patryk-homelab/ClaudeRepo/credits-3d/_wycofane_magnesy_2026-11-04/README.txt

Części na magnesy wycofane 04.11.2026 (decyzja Patryka: bez wklejania magnesów).
Pliki przeniesione tutaj z tymi samymi ścieżkami, jakie miały w credits-3d. Nic nie zostało skasowane; ostateczne usunięcie zostaje Patrykowi.
Powód dla każdej części: gniazda albo ramki na magnesy, sprawdzone przekrojami (narzedzia/magnet_pockets.py, wyniki w narzedzia/wyniki/magnes_*.json).
Amana i DeWalt: po 2 gniazda Ø6,1-6,2 mm na magnesy okrągłe 6 x 3 mm.

Później tego samego wieczoru (decyzja Patryka: wycofać wszystkie systemy z magnesami) przeniesiony tu cały folder 03_1051202 (także 3x7, 8x4, przegródki, etykiety, raport, rendery).
