patryk-homelab/ClaudeRepo/credits-3d/CREDITS.md

# Uznanie autorstwa (credits) — uchwyty na bity

Licencje sprawdzone 2026-11-04 w API Printables (pole `license`, `remixParents`). Żaden z 4 modeli nie jest remiksem (`remixParents: []`), więc nie ma licencji „wyżej w łańcuchu”.

| # | Projekt | Autor (Printables) | Link | Licencja | Sprzedaż wydruków | Obowiązek przy sprzedaży |
|---|---|---|---|---|---|---|
| 01 | Bit holder, organizer / Držák bitů | Jirka (`Jirka_4226633`) | https://www.printables.com/model/1770956 | CC0 (Public Domain) | tak | brak (podanie autora mile widziane) |
| 02 | Large bit holder (wall mounted) | Jirka (`Jirka_4226633`) | https://www.printables.com/model/1825701 | CC0 (Public Domain) | tak | brak (podanie autora mile widziane) |
| 03 | Ultimate Bit Holder | Carlos Gonzalez (`CarlosGonzal_2239591`) | https://www.printables.com/model/1051202 | CC BY (Creative Commons — Attribution) | tak | podać autora, tytuł, link i licencję; zaznaczyć zmiany — **wycofany 04.11.2026, nie sprzedawać** |
| 04 | Hex Bit Holder | GUZ_prints (`GUZ_prints_227736`) | https://www.printables.com/model/146076 | CC0 (Public Domain) | tak | brak (podanie autora mile widziane) |

## Teksty do wklejenia w ogłoszenie

**01 (CC0)**
> Projekt: „Bit holder, organizer” — Jirka, Printables (printables.com/model/1770956), licencja CC0.

**02 (CC0, wersja poprawiona)**
> Na bazie projektu „Large bit holder (wall mounted)” — Jirka, Printables (printables.com/model/1825701), licencja CC0. Zmiany: poszerzone gniazda w przednim rzędzie, otwory montażowe bez podpór.

**03 (CC BY — obowiązkowe)**
> (Wycofany 04.11.2026 – tekst zostaje tylko dla porządku.) Na bazie projektu „Ultimate Bit Holder” autorstwa Carlos Gonzalez, Printables (printables.com/model/1051202), licencja CC BY (Creative Commons — Uznanie autorstwa). Zmiany: naprawione siatki części 3x7 i 8x4 (bez zmiany kształtu).

Na OLX / Allegro Lokalnie, gdzie link może być niedozwolony: „Projekt: Ultimate Bit Holder, autor Carlos Gonzalez (Printables), licencja CC BY, zmodyfikowany”.

**04 (CC0, wersja poprawiona)**
> Na bazie projektu „Hex Bit Holder” — GUZ_prints, Printables (printables.com/model/146076), licencja CC0. Zmiany: dodane uszy montażowe z otworami na wkręty.

## Uwagi
- Nie pisać „projekt własny” przy żadnym z nich.
- Nazwy i logo marek z plików 03 (Amana, DeWalt) nie trafiają do tytułu ogłoszenia; to uchwyty pod konkretne narzędzia, nie produkty tych firm.
- Wersja licencji CC BY (3.0 / 4.0) nie jest podana w API Printables, tylko nazwa „Creative Commons — Attribution”.
