patryk-homelab/ClaudeRepo/credits-3d/wkretaki/CREDITS.md

# Uznanie autorstwa (credits) — uchwyty na wkrętaki

Licencje sprawdzone 2026-11-04 w API Printables (pola `license`, `remixParents`).

| # | Projekt | Autor (Printables) | Link | Licencja | Model nadrzędny | Obowiązek przy sprzedaży |
|---|---|---|---|---|---|---|
| 01 | Large screwdriver holder with honeycomb pattern | Jirka (`Jirka_4226633`) | https://www.printables.com/model/1808383 | CC0 | brak | brak (podanie autora mile widziane) |
| 02 | Large massive screwdriver holder / Masivní držák pro šroubováky | Jirka (`Jirka_4226633`) | https://www.printables.com/model/1782552 | CC0 | brak | brak |
| 03 | IKEA Skadis screwdriver holder / držák na šroubováky | Pavel (`Pavel_81109`) | https://www.printables.com/model/41393 | CC BY | brak | podać autora, tytuł, link, licencję; zaznaczyć zmiany |
| 04 | Wera Screwdriver Holder | ksuszka (`ksuszka_192195`), w skryptach: Krzysztof Suszka | https://www.printables.com/model/123412 | CC BY | Thingiverse thing:5213820 | podać autora, tytuł, link, licencję; zaznaczyć zmiany |

**04 — model nadrzędny.** Printables wskazuje Thingiverse thing:5213820. Według listingu-lustra (3dsearch.net, „Wera Screwdriver Holder by ksuszka”, widziany tylko w wynikach wyszukiwania) to upload tego samego autora. Strona Thingiverse zwraca z chmury błąd 403, więc licencji tamtej wersji nie odczytałem. Licencję CC BY na Printables nadał autor, więc jest ważna dla tej publikacji. Sprawdzenie strony Thingiverse w przeglądarce domowej zamknie tę kwestię.

## Teksty do ogłoszeń

**01 (CC0, poprawiony)**
> Na bazie projektu „Large screwdriver holder with honeycomb pattern” — Jirka, Printables (printables.com/model/1808383), licencja CC0. Zmiana: ujednolicony jeden otwór (bez podpór przy druku).

**02 (CC0, poprawiony)**
> Na bazie projektu „Large massive screwdriver holder” — Jirka, Printables (printables.com/model/1782552), licencja CC0. Zmiana: 21 niepełnych otworów przy krawędzi uzupełnionych do pełnego rozmiaru.

**03 (CC BY — obowiązkowe)**
> Projekt: „IKEA Skadis screwdriver holder” autorstwa Pavel, Printables (printables.com/model/41393), licencja CC BY (Creative Commons — Uznanie autorstwa). Pliki wyeksportowane z oryginalnego modelu FreeCAD autora, bez zmian kształtu.

**04 (CC BY — obowiązkowe)**
> Na bazie projektu „Wera Screwdriver Holder” autorstwa ksuszka (Krzysztof Suszka), Printables (printables.com/model/123412), licencja CC BY (Creative Commons — Uznanie autorstwa). Zmiana: szczelina odciążająca w zatrzasku (mniejsze ryzyko pęknięcia przy wpinaniu na szynę).

Na OLX / Allegro Lokalnie bez linku: „Projekt: <tytuł>, autor <autor> (Printables), licencja CC BY, zmodyfikowany”.

## Uwagi
- „IKEA”, „SKÅDIS” i „Wera” to nazwy cudzych marek. W ogłoszeniu tylko opisowo („pasuje do płyty IKEA SKÅDIS”, „do wkrętaków Wera”), bez logo i bez sugerowania, że to produkt tych firm.
- Wersja licencji CC BY (3.0 / 4.0) nie jest podana w API Printables, tylko nazwa „Creative Commons — Attribution”.
