patryk-homelab/ClaudeRepo/credits-3d/01_1770956_bit-holder-organizer_Jirka/render/oryginal.png

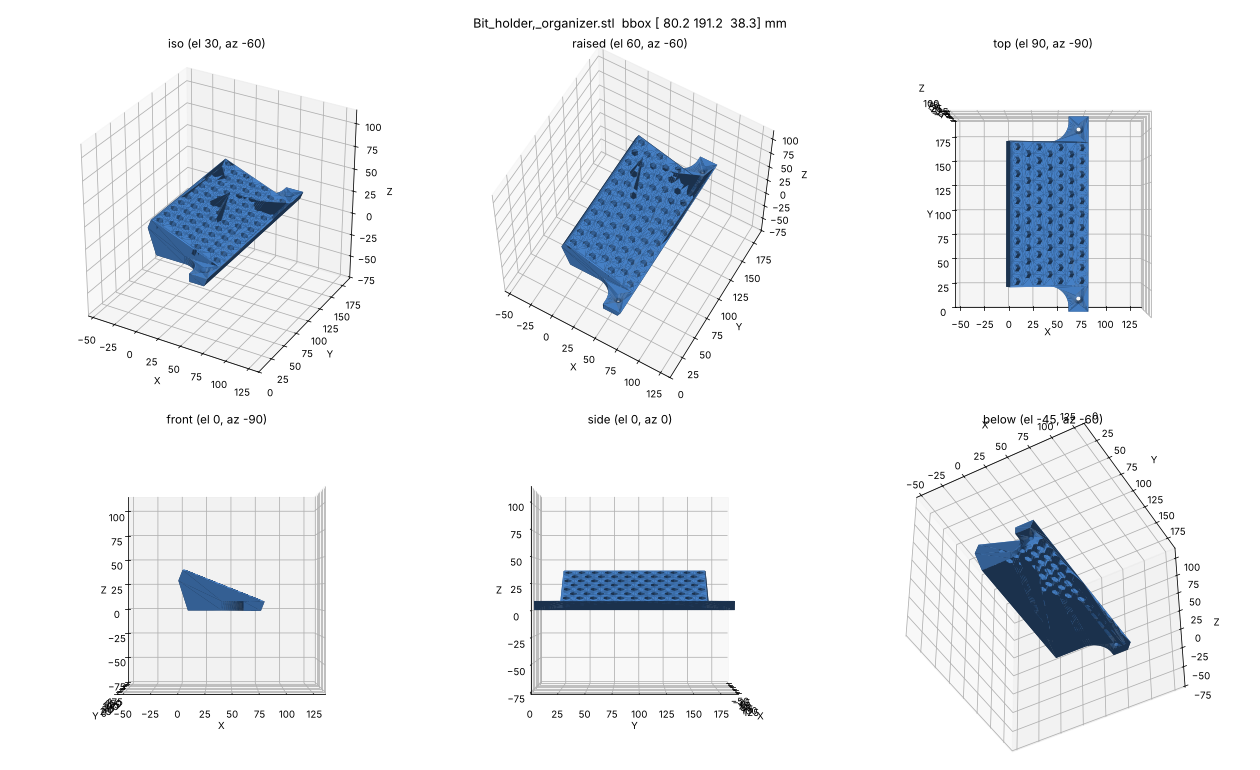
credits-3d/01_1770956_bit-holder-organizer_Jirka/render/oryginal.png
