patryk-homelab/ClaudeRepo/credits-3d/02_1825701_large-bit-holder_Jirka/render/oryginal_gniazda_z6.png

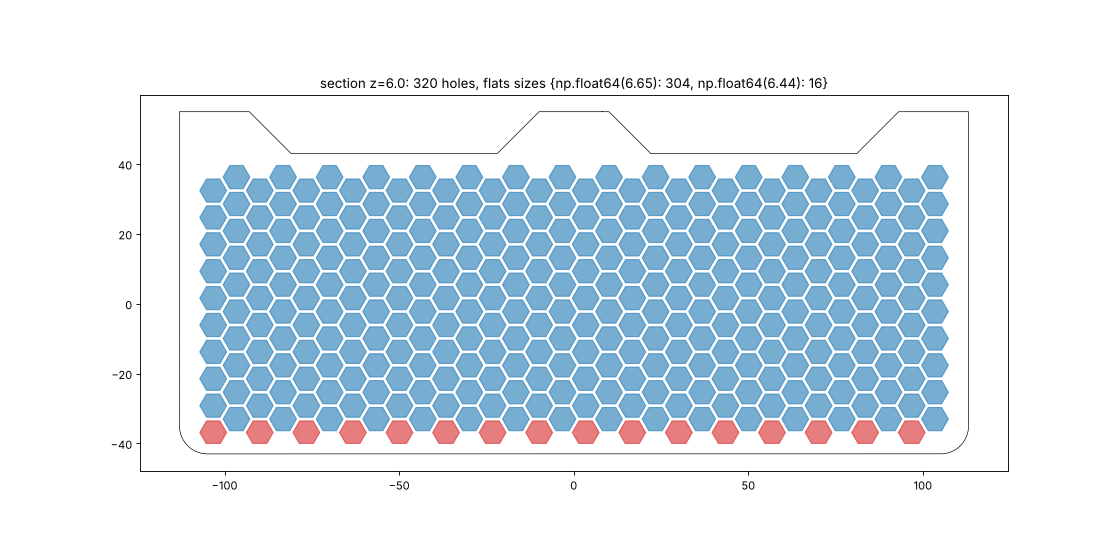
credits-3d/02_1825701_large-bit-holder_Jirka/render/oryginal_gniazda_z6.png
