patryk-homelab/ClaudeRepo/credits-3d/02_1825701_large-bit-holder_Jirka/render/poprawka_szczegoly.png

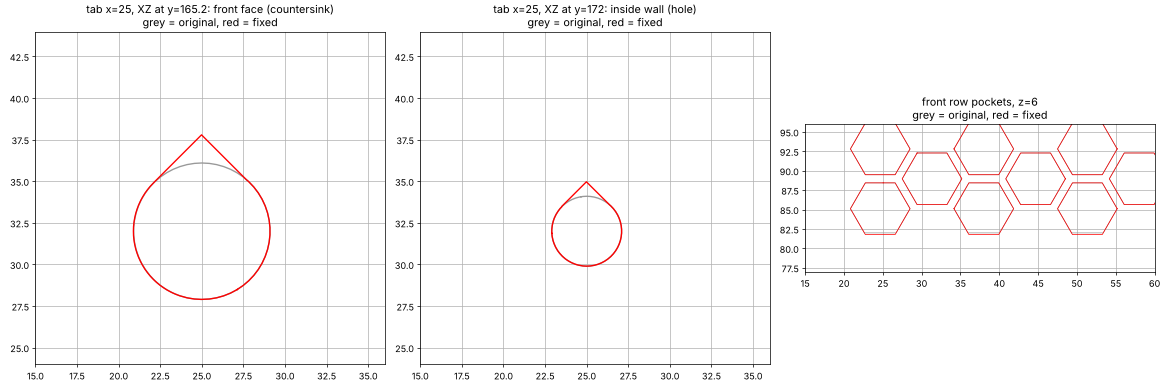
credits-3d/02_1825701_large-bit-holder_Jirka/render/poprawka_szczegoly.png
