patryk-homelab/ClaudeRepo/credits-3d/_wycofane_magnesy_2026-11-04/03_1051202_ultimate-bit-holder_CarlosGonzalez/render/8x4_naprawiony.png

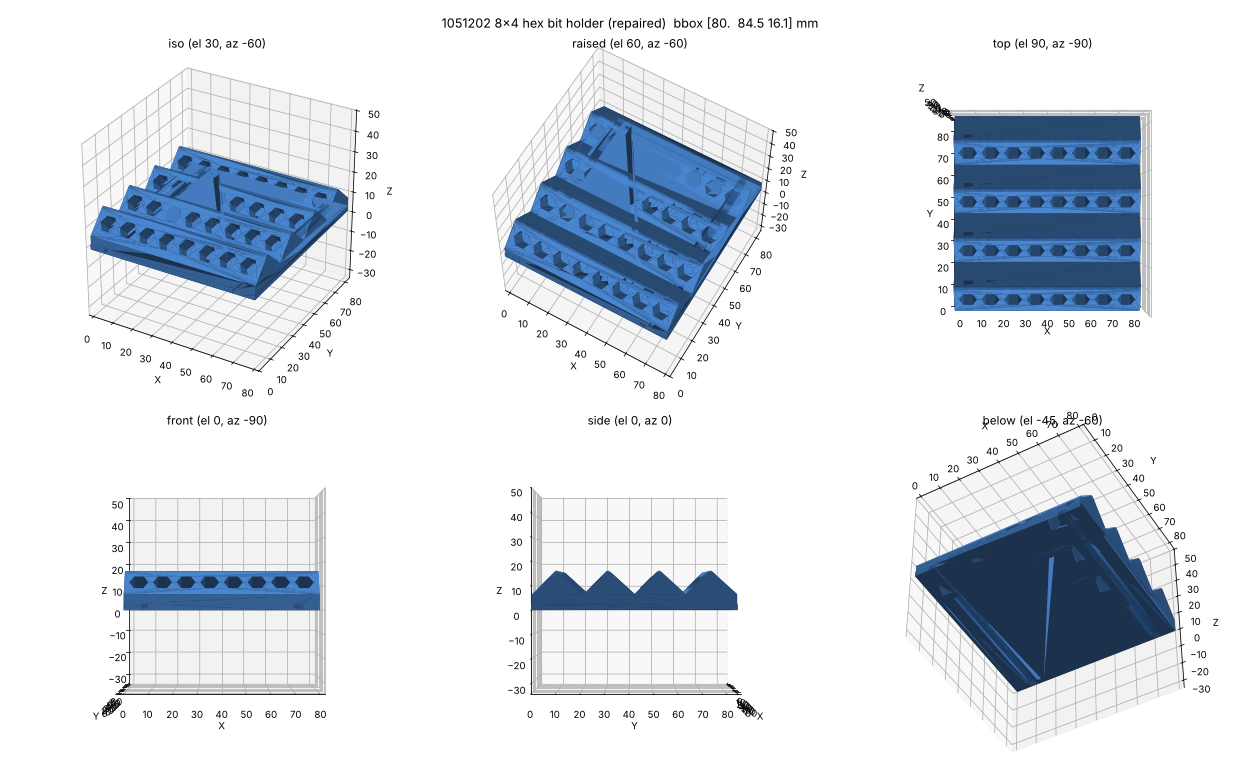
credits-3d/_wycofane_magnesy_2026-11-04/03_1051202_ultimate-bit-holder_CarlosGonzalez/render/8x4_naprawiony.png
