patryk-homelab/ClaudeRepo/credits-3d/wkretaki/01_1808383_large-screwdriver-holder-honeycomb_Jirka/render/poprawka_otwor.png

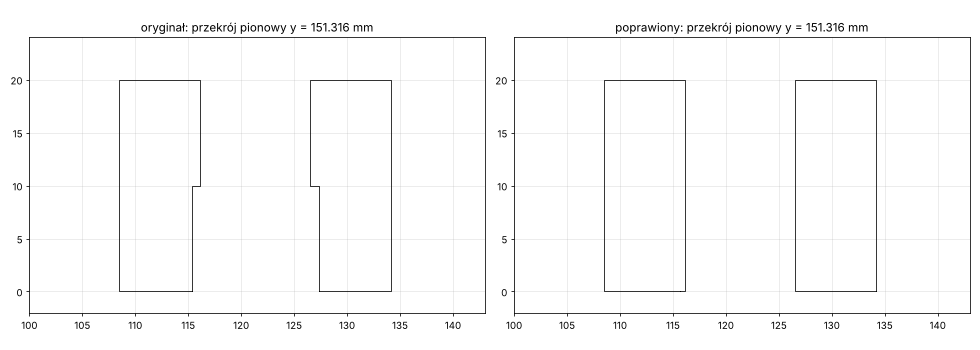
credits-3d/wkretaki/01_1808383_large-screwdriver-holder-honeycomb_Jirka/render/poprawka_otwor.png
