patryk-homelab/ClaudeRepo/credits-3d/wkretaki/02_1782552_large-massive-screwdriver-holder_Jirka/render/poprawka_otwory.png

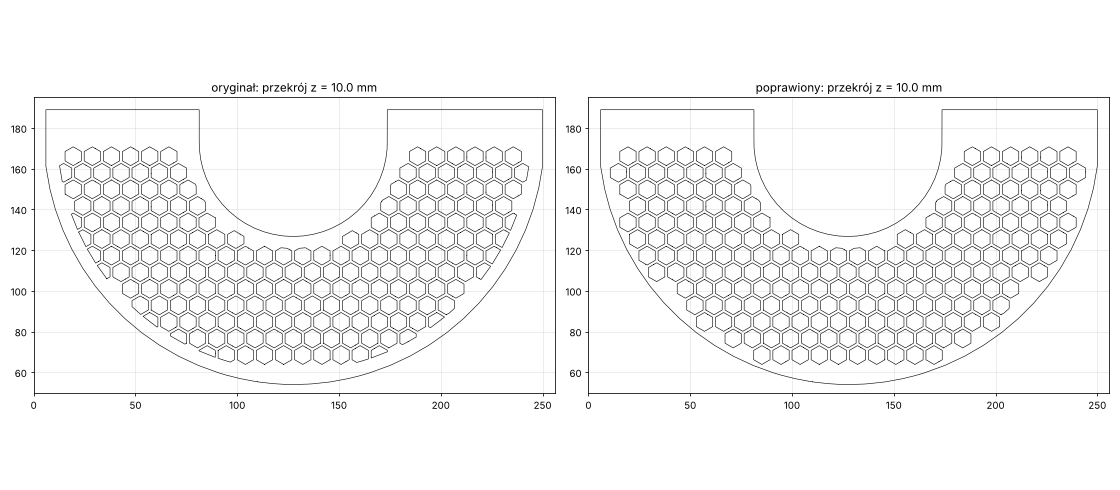
credits-3d/wkretaki/02_1782552_large-massive-screwdriver-holder_Jirka/render/poprawka_otwory.png
