patryk-homelab/ClaudeRepo/credits-3d/wkretaki/03_41393_ikea-skadis-screwdriver-holder_Pavel/render/oryginal_czesci.png

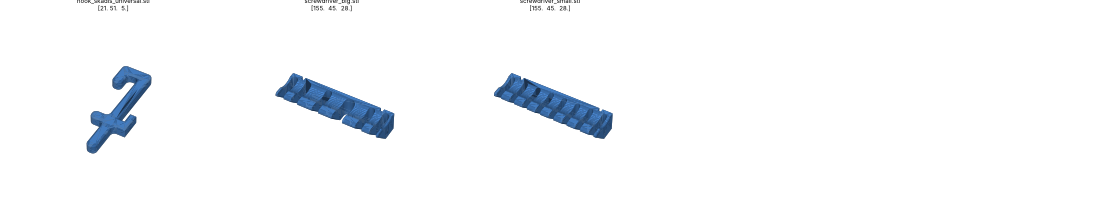
credits-3d/wkretaki/03_41393_ikea-skadis-screwdriver-holder_Pavel/render/oryginal_czesci.png
