patryk-homelab/ClaudeRepo/credits-3d/wkretaki/04_123412_wera-screwdriver-holder_ksuszka/render/poprawka_zatrzask.png

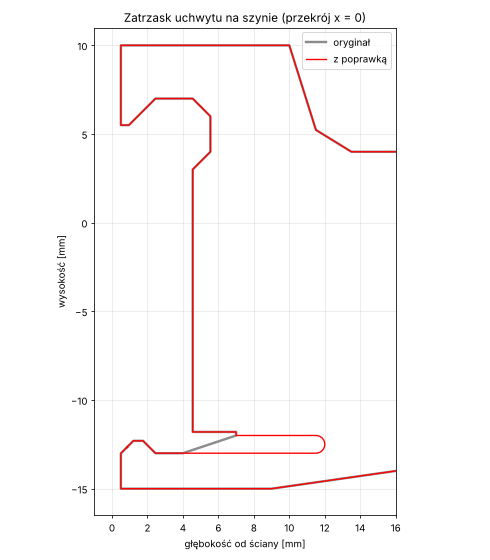
credits-3d/wkretaki/04_123412_wera-screwdriver-holder_ksuszka/render/poprawka_zatrzask.png
