patryk-homelab/ClaudeRepo/credits-3d/wkretaki/04_123412_wera-screwdriver-holder_ksuszka/render/zatrzask_i_szyna_profil.png

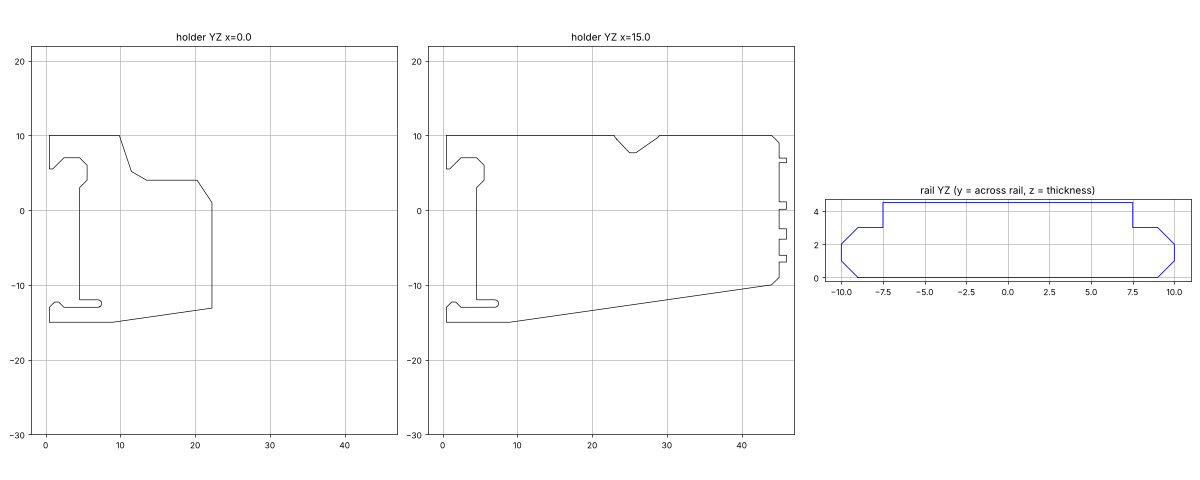
credits-3d/wkretaki/04_123412_wera-screwdriver-holder_ksuszka/render/zatrzask_i_szyna_profil.png
