patryk-homelab/ClaudeRepo/credits-3d/wkretaki/04_123412_wera-screwdriver-holder_ksuszka/warianty_P077_uchwyty_wera.csv

sku | nazwa | producent | seria | typ | rozmiar | wersja_pliku | status_autora | katalog_wera | na_start | filament_g | czas_h | podpory_fragmenty | plik_projektu | duplikat
P077-HOLEX-NUT10 | Holex 62 2200 nasadka 10 mm | Holex | 62 2200 | nasadka | 10 |  | nie ma na liście autora | nie dotyczy | nie (na zamówienie) | 14.88 | 0.92 | 19 | screwdriver_holder_holex_62_2200_nut_10_snapfix_X2D_PETG.3mf
P077-HOLEX-NUT11 | Holex 62 2200 nasadka 11 mm | Holex | 62 2200 | nasadka | 11 |  | nie ma na liście autora | nie dotyczy | nie (na zamówienie) | 14.75 | 0.92 | 19 | screwdriver_holder_holex_62_2200_nut_11_snapfix_X2D_PETG.3mf
P077-HOLEX-NUT12 | Holex 62 2200 nasadka 12 mm | Holex | 62 2200 | nasadka | 12 |  | nie ma na liście autora | nie dotyczy | nie (na zamówienie) | 14.75 | 0.93 | 19 | screwdriver_holder_holex_62_2200_nut_12_snapfix_X2D_PETG.3mf
P077-HOLEX-NUT13 | Holex 62 2200 nasadka 13 mm | Holex | 62 2200 | nasadka | 13 |  | nie ma na liście autora | nie dotyczy | nie (na zamówienie) | 14.75 | 0.92 | 19 | screwdriver_holder_holex_62_2200_nut_13_snapfix_X2D_PETG.3mf
P077-HOLEX-NUT4 | Holex 62 2200 nasadka 4 mm | Holex | 62 2200 | nasadka | 4 |  | nie ma na liście autora | nie dotyczy | nie (na zamówienie) | 14.99 | 0.92 | 19 | screwdriver_holder_holex_62_2200_nut_4_snapfix_X2D_PETG.3mf
P077-HOLEX-NUT4.5 | Holex 62 2200 nasadka 4.5 mm | Holex | 62 2200 | nasadka | 4.5 |  | nie ma na liście autora | nie dotyczy | nie (na zamówienie) | 15.0 | 0.92 | 19 | screwdriver_holder_holex_62_2200_nut_45_snapfix_X2D_PETG.3mf
P077-HOLEX-NUT5 | Holex 62 2200 nasadka 5 mm | Holex | 62 2200 | nasadka | 5 |  | nie ma na liście autora | nie dotyczy | nie (na zamówienie) | 14.99 | 0.92 | 19 | screwdriver_holder_holex_62_2200_nut_5_snapfix_X2D_PETG.3mf
P077-HOLEX-NUT5.5 | Holex 62 2200 nasadka 5.5 mm | Holex | 62 2200 | nasadka | 5.5 |  | nie ma na liście autora | nie dotyczy | nie (na zamówienie) | 15.01 | 0.92 | 19 | screwdriver_holder_holex_62_2200_nut_55_snapfix_X2D_PETG.3mf
P077-HOLEX-NUT6 | Holex 62 2200 nasadka 6 mm | Holex | 62 2200 | nasadka | 6 |  | nie ma na liście autora | nie dotyczy | nie (na zamówienie) | 14.99 | 0.92 | 19 | screwdriver_holder_holex_62_2200_nut_6_snapfix_X2D_PETG.3mf
P077-HOLEX-NUT7 | Holex 62 2200 nasadka 7 mm | Holex | 62 2200 | nasadka | 7 |  | nie ma na liście autora | nie dotyczy | nie (na zamówienie) | 14.87 | 0.92 | 19 | screwdriver_holder_holex_62_2200_nut_7_snapfix_X2D_PETG.3mf
P077-HOLEX-NUT8 | Holex 62 2200 nasadka 8 mm | Holex | 62 2200 | nasadka | 8 |  | nie ma na liście autora | nie dotyczy | nie (na zamówienie) | 14.87 | 0.92 | 19 | screwdriver_holder_holex_62_2200_nut_8_snapfix_X2D_PETG.3mf
P077-HOLEX-NUT9 | Holex 62 2200 nasadka 9 mm | Holex | 62 2200 | nasadka | 9 |  | nie ma na liście autora | nie dotyczy | nie (na zamówienie) | 14.87 | 0.92 | 19 | screwdriver_holder_holex_62_2200_nut_9_snapfix_X2D_PETG.3mf
P077-1427-AWL | Wera 1427 szydło | Wera | 1427 | szydło |  |  | nie ma na liście autora | nie dotyczy | nie (na zamówienie) | 13.92 | 0.91 | 19 | screwdriver_holder_wera_1427_awl_snapfix_X2D_PETG.3mf
P077-1428-REAMER | Wera 1428 rozwiertak | Wera | 1428 | rozwiertak |  |  | nie ma na liście autora | nie dotyczy | nie (na zamówienie) | 13.92 | 0.91 | 19 | screwdriver_holder_wera_1428_reamer_snapfix_X2D_PETG.3mf
P077-160IS-FL4 | Wera 160iS VDE płaski 4 mm | Wera | 160iS | flat | 4 |  | nieprzetestowany (wymiary z katalogu Wera) | zgodny | nie (na zamówienie) | 13.43 | 0.91 | 19 | screwdriver_holder_wera_160iS_vde_flat_40_snapfix_X2D_PETG.3mf
P077-160IS-FL5.5 | Wera 160iS VDE płaski 5.5 mm | Wera | 160iS | flat | 5.5 |  | nieprzetestowany (wymiary z katalogu Wera) | zgodny | nie (na zamówienie) | 13.68 | 0.91 | 19 | screwdriver_holder_wera_160iS_vde_flat_55_snapfix_X2D_PETG.3mf
P077-160I-FL2.5 | Wera 160i VDE płaski 2.5 mm | Wera | 160i | flat | 2.5 |  | przetestowany przez autora | zgodny | tak | 12.98 | 0.9 | 19 | screwdriver_holder_wera_160i_vde_flat_25_snapfix_X2D_PETG.3mf | tak – wybrać jeden przed wystawieniem
P077-160I-FL2.5-V2 | Wera 160i VDE płaski 2.5 mm | Wera | 160i | flat | 2.5 | v2 | przetestowany przez autora | zgodny | tak | 13.04 | 0.9 | 19 | screwdriver_holder_wera_160i_vde_flat_25_v2_snapfix_X2D_PETG.3mf | tak – wybrać jeden przed wystawieniem
P077-160I-FL3-V2 | Wera 160i VDE płaski 3 mm | Wera | 160i | flat | 3 | v2 | przetestowany przez autora | zgodny | tak | 13.25 | 0.9 | 19 | screwdriver_holder_wera_160i_vde_flat_30_v2_snapfix_X2D_PETG.3mf
P077-160I-FL3.5 | Wera 160i VDE płaski 3.5 mm | Wera | 160i | flat | 3.5 |  | nie ma na liście autora | zgodny | nie (na zamówienie) | 13.23 | 0.9 | 19 | screwdriver_holder_wera_160i_vde_flat_35_snapfix_X2D_PETG.3mf | tak – wybrać jeden przed wystawieniem
P077-160I-FL3.5-V2 | Wera 160i VDE płaski 3.5 mm | Wera | 160i | flat | 3.5 | v2 | nie ma na liście autora | zgodny | nie (na zamówienie) | 13.25 | 0.9 | 19 | screwdriver_holder_wera_160i_vde_flat_35_v2_snapfix_X2D_PETG.3mf | tak – wybrać jeden przed wystawieniem
P077-160I-FL6.5-V2 | Wera 160i VDE płaski 6.5 mm | Wera | 160i | flat | 6.5 | v2 | nie ma na liście autora | zgodny | nie (na zamówienie) | 13.52 | 0.91 | 19 | screwdriver_holder_wera_160i_vde_flat_65_v2_snapfix_X2D_PETG.3mf
P077-162IS-PH1 | Wera 162iS VDE PH1 | Wera | 162iS | PH | 1 |  | nieprzetestowany (wymiary z katalogu Wera) | zgodny | nie (na zamówienie) | 13.43 | 0.91 | 19 | screwdriver_holder_wera_162iS_vde_ph_1_snapfix_X2D_PETG.3mf
P077-162IS-PH2 | Wera 162iS VDE PH2 | Wera | 162iS | PH | 2 |  | nieprzetestowany (wymiary z katalogu Wera) | zgodny | nie (na zamówienie) | 13.54 | 0.91 | 19 | screwdriver_holder_wera_162iS_vde_ph_2_snapfix_X2D_PETG.3mf
P077-162I-PH0 | Wera 162i VDE PH0 | Wera | 162i | PH | 0 |  | nie ma na liście autora | zgodny | nie (na zamówienie) | 13.0 | 0.89 | 19 | screwdriver_holder_wera_162i_vde_ph_0_snapfix_X2D_PETG.3mf
P077-162I-PH2-V2 | Wera 162i VDE PH2 | Wera | 162i | PH | 2 | v2 | nie ma na liście autora | zgodny | nie (na zamówienie) | 13.55 | 0.91 | 19 | screwdriver_holder_wera_162i_vde_ph_2_v2_snapfix_X2D_PETG.3mf
P077-162I-PH3-V2 | Wera 162i VDE PH3 | Wera | 162i | PH | 3 | v2 | nie ma na liście autora | zgodny | nie (na zamówienie) | 14.42 | 0.93 | 19 | screwdriver_holder_wera_162i_vde_ph_3_v2_snapfix_X2D_PETG.3mf
P077-162I-PH4-V2 | Wera 162i VDE PH4 | Wera | 162i | PH | 4 | v2 | nie ma na liście autora | zgodny | nie (na zamówienie) | 14.17 | 0.93 | 19 | screwdriver_holder_wera_162i_vde_ph_4_v2_snapfix_X2D_PETG.3mf
P077-165IS-PZ1 | Wera 165iS VDE PZ1 | Wera | 165iS | PZ | 1 |  | nieprzetestowany (wymiary z katalogu Wera) | zgodny | nie (na zamówienie) | 13.44 | 0.91 | 19 | screwdriver_holder_wera_165iS_vde_pz_1_snapfix_X2D_PETG.3mf
P077-165IS-PZ2 | Wera 165iS VDE PZ2 | Wera | 165iS | PZ | 2 |  | nieprzetestowany (wymiary z katalogu Wera) | zgodny | nie (na zamówienie) | 13.55 | 0.91 | 19 | screwdriver_holder_wera_165iS_vde_pz_2_snapfix_X2D_PETG.3mf
P077-165IS-PZS1 | Wera 165iS VDE PZ/S1 | Wera | 165iS | PZ/S | 1 |  | nieprzetestowany (wymiary z katalogu Wera) | zgodny | nie (na zamówienie) | 13.41 | 0.91 | 19 | screwdriver_holder_wera_165iS_vde_pzs_1_snapfix_X2D_PETG.3mf
P077-165IS-PZS2 | Wera 165iS VDE PZ/S2 | Wera | 165iS | PZ/S | 2 |  | nieprzetestowany (wymiary z katalogu Wera) | zgodny | nie (na zamówienie) | 13.53 | 0.91 | 19 | screwdriver_holder_wera_165iS_vde_pzs_2_snapfix_X2D_PETG.3mf
P077-167I-TX10 | Wera 167i VDE TX10 | Wera | 167i | TX | 10 |  | nie ma na liście autora | zgodny | nie (na zamówienie) | 13.34 | 0.9 | 19 | screwdriver_holder_wera_167i_vde_tx_10_snapfix_X2D_PETG.3mf
P077-167I-TX15 | Wera 167i VDE TX15 | Wera | 167i | TX | 15 |  | nie ma na liście autora | zgodny | nie (na zamówienie) | 13.44 | 0.91 | 19 | screwdriver_holder_wera_167i_vde_tx_15_snapfix_X2D_PETG.3mf
P077-167I-TX20 | Wera 167i VDE TX20 | Wera | 167i | TX | 20 |  | nie ma na liście autora | zgodny | nie (na zamówienie) | 13.45 | 0.91 | 19 | screwdriver_holder_wera_167i_vde_tx_20_snapfix_X2D_PETG.3mf
P077-167I-TX25 | Wera 167i VDE TX25 | Wera | 167i | TX | 25 |  | nie ma na liście autora | zgodny | nie (na zamówienie) | 13.56 | 0.92 | 19 | screwdriver_holder_wera_167i_vde_tx_25_snapfix_X2D_PETG.3mf
P077-167I-TX30 | Wera 167i VDE TX30 | Wera | 167i | TX | 30 |  | nie ma na liście autora | zgodny | nie (na zamówienie) | 13.54 | 0.91 | 19 | screwdriver_holder_wera_167i_vde_tx_30_snapfix_X2D_PETG.3mf
P077-167I-TX5 | Wera 167i VDE TX5 | Wera | 167i | TX | 5 |  | nie ma na liście autora | zgodny | nie (na zamówienie) | 13.34 | 0.9 | 19 | screwdriver_holder_wera_167i_vde_tx_5_snapfix_X2D_PETG.3mf
P077-167I-TX6 | Wera 167i VDE TX6 | Wera | 167i | TX | 6 |  | nie ma na liście autora | zgodny | nie (na zamówienie) | 13.33 | 0.9 | 19 | screwdriver_holder_wera_167i_vde_tx_6_snapfix_X2D_PETG.3mf
P077-167I-TX7 | Wera 167i VDE TX7 | Wera | 167i | TX | 7 |  | nie ma na liście autora | zgodny | nie (na zamówienie) | 13.33 | 0.9 | 19 | screwdriver_holder_wera_167i_vde_tx_7_snapfix_X2D_PETG.3mf
P077-167I-TX8 | Wera 167i VDE TX8 | Wera | 167i | TX | 8 |  | nie ma na liście autora | zgodny | nie (na zamówienie) | 13.34 | 0.9 | 19 | screwdriver_holder_wera_167i_vde_tx_8_snapfix_X2D_PETG.3mf
P077-167I-TX9 | Wera 167i VDE TX9 | Wera | 167i | TX | 9 |  | nie ma na liście autora | zgodny | nie (na zamówienie) | 13.33 | 0.9 | 19 | screwdriver_holder_wera_167i_vde_tx_9_snapfix_X2D_PETG.3mf
P077-168I-SQ1 | Wera 168i VDE kwadrat #1 | Wera | 168i | square | #1 |  | nie ma na liście autora | brak danych w katalogu | nie (na zamówienie) | 13.4 | 0.91 | 19 | screwdriver_holder_wera_168i_vde_square_1_snapfix_X2D_PETG.3mf
P077-168I-SQ2 | Wera 168i VDE kwadrat #2 | Wera | 168i | square | #2 |  | nie ma na liście autora | brak danych w katalogu | nie (na zamówienie) | 13.52 | 0.91 | 19 | screwdriver_holder_wera_168i_vde_square_2_snapfix_X2D_PETG.3mf
P077-168I-SQ3 | Wera 168i VDE kwadrat #3 | Wera | 168i | square | #3 |  | nie ma na liście autora | brak danych w katalogu | nie (na zamówienie) | 14.52 | 0.93 | 19 | screwdriver_holder_wera_168i_vde_square_3_snapfix_X2D_PETG.3mf
P077-247-FL3 | Wera 247 płaski 3 mm | Wera | 247 | flat | 3 |  | przetestowany przez autora | brak danych w katalogu | tak | 13.2 | 0.9 | 19 | screwdriver_holder_wera_247_flat_30_snapfix_X2D_PETG.3mf
P077-334-FL10 | Wera 334 płaski 10 mm | Wera | 334 | flat | 10 |  | nieprzetestowany (wymiary z katalogu Wera) | zgodny | nie (na zamówienie) | 14.59 | 0.93 | 19 | screwdriver_holder_wera_334_flat_100_snapfix_X2D_PETG.3mf
P077-334-FL5 | Wera 334 płaski 5 mm | Wera | 334 | flat | 5 |  | nieprzetestowany (wymiary z katalogu Wera) | zgodny | nie (na zamówienie) | 13.42 | 0.92 | 197 | screwdriver_holder_wera_334_flat_50_snapfix_X2D_PETG.3mf
P077-334-FL6 | Wera 334 płaski 6 mm | Wera | 334 | flat | 6 |  | nieprzetestowany (wymiary z katalogu Wera) | zgodny | nie (na zamówienie) | 13.79 | 0.91 | 19 | screwdriver_holder_wera_334_flat_60_snapfix_X2D_PETG.3mf
P077-334-FL6.5X150 | Wera 334 płaski 6.5x150 mm | Wera | 334 | flat | 6.5x150 |  | przetestowany przez autora | zgodny | tak | 13.79 | 0.91 | 19 | screwdriver_holder_wera_334_flat_65x150_snapfix_X2D_PETG.3mf
P077-334-FL6.5X200 | Wera 334 płaski 6.5x200 mm | Wera | 334 | flat | 6.5x200 |  | nieprzetestowany (wymiary z katalogu Wera) | zgodny | nie (na zamówienie) | 13.72 | 0.91 | 19 | screwdriver_holder_wera_334_flat_65x200_snapfix_X2D_PETG.3mf
P077-334-FL7 | Wera 334 płaski 7 mm | Wera | 334 | flat | 7 |  | nieprzetestowany (wymiary z katalogu Wera) | zgodny | nie (na zamówienie) | 13.72 | 0.91 | 19 | screwdriver_holder_wera_334_flat_70_snapfix_X2D_PETG.3mf
P077-334-FL8 | Wera 334 płaski 8 mm | Wera | 334 | flat | 8 |  | nieprzetestowany (wymiary z katalogu Wera) | zgodny | nie (na zamówienie) | 14.76 | 0.93 | 19 | screwdriver_holder_wera_334_flat_80_snapfix_X2D_PETG.3mf
P077-335-FL2.5 | Wera 335 płaski 2.5 mm | Wera | 335 | flat | 2.5 |  | nieprzetestowany (wymiary z katalogu Wera) | zgodny | nie (na zamówienie) | 13.29 | 0.89 | 19 | screwdriver_holder_wera_335_flat_25_snapfix_X2D_PETG.3mf
P077-335-FL3 | Wera 335 płaski 3 mm | Wera | 335 | flat | 3 |  | nieprzetestowany (wymiary z katalogu Wera) | zgodny | nie (na zamówienie) | 13.19 | 0.9 | 19 | screwdriver_holder_wera_335_flat_30_snapfix_X2D_PETG.3mf
P077-335-FL3.5 | Wera 335 płaski 3.5 mm | Wera | 335 | flat | 3.5 |  | przetestowany przez autora | zgodny | tak | 13.25 | 0.9 | 19 | screwdriver_holder_wera_335_flat_35_snapfix_X2D_PETG.3mf
P077-335-FL4 | Wera 335 płaski 4 mm | Wera | 335 | flat | 4 |  | przetestowany przez autora | zgodny | tak | 13.49 | 0.92 | 197 | screwdriver_holder_wera_335_flat_40_snapfix_X2D_PETG.3mf
P077-335-FL5.5 | Wera 335 płaski 5.5 mm | Wera | 335 | flat | 5.5 |  | nieprzetestowany (wymiary z katalogu Wera) | zgodny | nie (na zamówienie) | 13.38 | 0.92 | 196 | screwdriver_holder_wera_335_flat_55_snapfix_X2D_PETG.3mf
P077-335-FL5.5-24 | Wera 335 płaski 5.5 mm (otwór 24 mm) | Wera | 335 | flat | 5.5 |  | wariant: otwór rękojeści 24 mm (nie ma na liście autora) | zgodny | nie (na zamówienie) | 12.94 | 0.9 | 19 | screwdriver_holder_wera_335_flat_55_24mm_snapfix_X2D_PETG.3mf
P077-335-FL6 | Wera 335 płaski 6 mm | Wera | 335 | flat | 6 |  | nieprzetestowany (wymiary z katalogu Wera) | zgodny | nie (na zamówienie) | 13.79 | 0.91 | 19 | screwdriver_holder_wera_335_flat_60_snapfix_X2D_PETG.3mf
P077-350-PH0 | Wera 350 PH0 | Wera | 350 | PH | 0 |  | nieprzetestowany (wymiary z katalogu Wera) | zgodny | nie (na zamówienie) | 13.32 | 0.9 | 19 | screwdriver_holder_wera_350_ph_0_snapfix_X2D_PETG.3mf
P077-350-PH1 | Wera 350 PH1 | Wera | 350 | PH | 1 |  | przetestowany przez autora | zgodny | tak | 13.43 | 0.92 | 197 | screwdriver_holder_wera_350_ph_1_snapfix_X2D_PETG.3mf
P077-350-PH1-24 | Wera 350 PH1 (otwór 24 mm) | Wera | 350 | PH | 1 |  | wariant: otwór rękojeści 24 mm (nie ma na liście autora) | zgodny | nie (na zamówienie) | 13.02 | 0.9 | 19 | screwdriver_holder_wera_350_ph_1_24mm_snapfix_X2D_PETG.3mf
P077-350-PH2 | Wera 350 PH2 | Wera | 350 | PH | 2 |  | przetestowany przez autora | zgodny | tak | 13.76 | 0.91 | 19 | screwdriver_holder_wera_350_ph_2_snapfix_X2D_PETG.3mf
P077-350-PH3 | Wera 350 PH3 | Wera | 350 | PH | 3 |  | przetestowany przez autora | zgodny | tak | 14.76 | 0.93 | 19 | screwdriver_holder_wera_350_ph_3_snapfix_X2D_PETG.3mf
P077-350-PH4 | Wera 350 PH4 | Wera | 350 | PH | 4 |  | nieprzetestowany (wymiary z katalogu Wera) | zgodny | nie (na zamówienie) | 14.6 | 0.93 | 19 | screwdriver_holder_wera_350_ph_4_snapfix_X2D_PETG.3mf
P077-352-HEX10 | Wera 352 imbus 10 mm | Wera | 352 | hex | 10 |  | nieprzetestowany (wymiary z katalogu Wera) | brak danych w katalogu | nie (na zamówienie) | 14.36 | 0.93 | 19 | screwdriver_holder_wera_352_hex_100_snapfix_X2D_PETG.3mf
P077-352-HEX1.5 | Wera 352 imbus 1.5 mm | Wera | 352 | hex | 1.5 |  | nieprzetestowany (wymiary z katalogu Wera) | brak danych w katalogu | nie (na zamówienie) | 13.7 | 0.91 | 180 | screwdriver_holder_wera_352_hex_15_snapfix_X2D_PETG.3mf
P077-352-HEX2 | Wera 352 imbus 2 mm | Wera | 352 | hex | 2 |  | nieprzetestowany (wymiary z katalogu Wera) | brak danych w katalogu | nie (na zamówienie) | 13.69 | 0.91 | 180 | screwdriver_holder_wera_352_hex_20_snapfix_X2D_PETG.3mf
P077-352-HEX2.5 | Wera 352 imbus 2.5 mm | Wera | 352 | hex | 2.5 |  | nieprzetestowany (wymiary z katalogu Wera) | brak danych w katalogu | nie (na zamówienie) | 13.32 | 0.9 | 19 | screwdriver_holder_wera_352_hex_25_snapfix_X2D_PETG.3mf
P077-352-HEX3 | Wera 352 imbus 3 mm | Wera | 352 | hex | 3 |  | nieprzetestowany (wymiary z katalogu Wera) | brak danych w katalogu | nie (na zamówienie) | 13.19 | 0.9 | 19 | screwdriver_holder_wera_352_hex_30_snapfix_X2D_PETG.3mf
P077-352-HEX4 | Wera 352 imbus 4 mm | Wera | 352 | hex | 4 |  | nieprzetestowany (wymiary z katalogu Wera) | brak danych w katalogu | nie (na zamówienie) | 13.41 | 0.92 | 197 | screwdriver_holder_wera_352_hex_40_snapfix_X2D_PETG.3mf
P077-352-HEX5 | Wera 352 imbus 5 mm | Wera | 352 | hex | 5 |  | nieprzetestowany (wymiary z katalogu Wera) | brak danych w katalogu | nie (na zamówienie) | 13.79 | 0.91 | 19 | screwdriver_holder_wera_352_hex_50_snapfix_X2D_PETG.3mf
P077-352-HEX6 | Wera 352 imbus 6 mm | Wera | 352 | hex | 6 |  | nieprzetestowany (wymiary z katalogu Wera) | brak danych w katalogu | nie (na zamówienie) | 13.72 | 0.92 | 19 | screwdriver_holder_wera_352_hex_60_snapfix_X2D_PETG.3mf
P077-352-HEX8 | Wera 352 imbus 8 mm | Wera | 352 | hex | 8 |  | nieprzetestowany (wymiary z katalogu Wera) | brak danych w katalogu | nie (na zamówienie) | 14.6 | 0.93 | 19 | screwdriver_holder_wera_352_hex_80_snapfix_X2D_PETG.3mf
P077-355-PZ0 | Wera 355 PZ0 | Wera | 355 | PZ | 0 |  | nieprzetestowany (wymiary z katalogu Wera) | zgodny | nie (na zamówienie) | 13.32 | 0.9 | 19 | screwdriver_holder_wera_355_pz_0_snapfix_X2D_PETG.3mf
P077-355-PZ1 | Wera 355 PZ1 | Wera | 355 | PZ | 1 |  | przetestowany przez autora | zgodny | tak | 13.43 | 0.92 | 197 | screwdriver_holder_wera_355_pz_1_snapfix_X2D_PETG.3mf
P077-355-PZ2 | Wera 355 PZ2 | Wera | 355 | PZ | 2 |  | przetestowany przez autora | zgodny | tak | 13.76 | 0.91 | 19 | screwdriver_holder_wera_355_pz_2_snapfix_X2D_PETG.3mf
P077-355-PZ3 | Wera 355 PZ3 | Wera | 355 | PZ | 3 |  | przetestowany przez autora | zgodny | tak | 14.77 | 0.93 | 19 | screwdriver_holder_wera_355_pz_3_snapfix_X2D_PETG.3mf
P077-355-PZ4 | Wera 355 PZ4 | Wera | 355 | PZ | 4 |  | nieprzetestowany (wymiary z katalogu Wera) | zgodny | nie (na zamówienie) | 14.61 | 0.93 | 19 | screwdriver_holder_wera_355_pz_4_snapfix_X2D_PETG.3mf
P077-367-TX10 | Wera 367 TX10 | Wera | 367 | TX | 10 |  | przetestowany przez autora | zgodny | tak | 13.21 | 0.9 | 19 | screwdriver_holder_wera_367_tx_10_snapfix_X2D_PETG.3mf
P077-367-TX15 | Wera 367 TX15 | Wera | 367 | TX | 15 |  | przetestowany przez autora | zgodny | tak | 13.51 | 0.92 | 197 | screwdriver_holder_wera_367_tx_15_snapfix_X2D_PETG.3mf
P077-367-TX15-24 | Wera 367 TX15 (otwór 24 mm) | Wera | 367 | TX | 15 |  | wariant: otwór rękojeści 24 mm (nie ma na liście autora) | zgodny | nie (na zamówienie) | 13.07 | 0.9 | 19 | screwdriver_holder_wera_367_tx_15_24mm_snapfix_X2D_PETG.3mf
P077-367-TX20 | Wera 367 TX20 | Wera | 367 | TX | 20 |  | przetestowany przez autora | zgodny | tak | 13.45 | 0.92 | 197 | screwdriver_holder_wera_367_tx_20_snapfix_X2D_PETG.3mf
P077-367-TX20-24 | Wera 367 TX20 (otwór 24 mm) | Wera | 367 | TX | 20 |  | wariant: otwór rękojeści 24 mm (nie ma na liście autora) | zgodny | nie (na zamówienie) | 13.02 | 0.9 | 19 | screwdriver_holder_wera_367_tx_20_24mm_snapfix_X2D_PETG.3mf
P077-367-TX25 | Wera 367 TX25 | Wera | 367 | TX | 25 |  | przetestowany przez autora | zgodny | tak | 13.84 | 0.91 | 19 | screwdriver_holder_wera_367_tx_25_snapfix_X2D_PETG.3mf
P077-367-TX25-27 | Wera 367 TX25 (otwór 27 mm) | Wera | 367 | TX | 25 |  | wariant: otwór rękojeści 27 mm (nie ma na liście autora) | zgodny | nie (na zamówienie) | 13.81 | 0.92 | 19 | screwdriver_holder_wera_367_tx_25_27mm_snapfix_X2D_PETG.3mf
P077-367-TX27 | Wera 367 TX27 | Wera | 367 | TX | 27 |  | nieprzetestowany (wymiary z katalogu Wera) | zgodny | nie (na zamówienie) | 13.84 | 0.92 | 19 | screwdriver_holder_wera_367_tx_27_snapfix_X2D_PETG.3mf
P077-367-TX30 | Wera 367 TX30 | Wera | 367 | TX | 30 |  | przetestowany przez autora | zgodny | tak | 13.81 | 0.92 | 19 | screwdriver_holder_wera_367_tx_30_snapfix_X2D_PETG.3mf
P077-367-TX40 | Wera 367 TX40 | Wera | 367 | TX | 40 |  | nieprzetestowany (wymiary z katalogu Wera) | zgodny | nie (na zamówienie) | 14.85 | 0.93 | 19 | screwdriver_holder_wera_367_tx_40_snapfix_X2D_PETG.3mf
P077-367-TX5 | Wera 367 TX5 | Wera | 367 | TX | 5 |  | nieprzetestowany (wymiary z katalogu Wera) | zgodny | nie (na zamówienie) | 13.29 | 0.9 | 19 | screwdriver_holder_wera_367_tx_5_snapfix_X2D_PETG.3mf
P077-367-TX6 | Wera 367 TX6 | Wera | 367 | TX | 6 |  | nieprzetestowany (wymiary z katalogu Wera) | zgodny | nie (na zamówienie) | 13.29 | 0.9 | 19 | screwdriver_holder_wera_367_tx_6_snapfix_X2D_PETG.3mf
P077-367-TX7 | Wera 367 TX7 | Wera | 367 | TX | 7 |  | nieprzetestowany (wymiary z katalogu Wera) | zgodny | nie (na zamówienie) | 13.29 | 0.9 | 19 | screwdriver_holder_wera_367_tx_7_snapfix_X2D_PETG.3mf
P077-367-TX8 | Wera 367 TX8 | Wera | 367 | TX | 8 |  | nieprzetestowany (wymiary z katalogu Wera) | zgodny | nie (na zamówienie) | 13.26 | 0.9 | 19 | screwdriver_holder_wera_367_tx_8_snapfix_X2D_PETG.3mf
P077-367-TX9 | Wera 367 TX9 | Wera | 367 | TX | 9 |  | nieprzetestowany (wymiary z katalogu Wera) | zgodny | nie (na zamówienie) | 13.2 | 0.9 | 19 | screwdriver_holder_wera_367_tx_9_snapfix_X2D_PETG.3mf
P077-368-SQ0 | Wera 368 kwadrat #0 | Wera | 368 | square | #0 |  | nie ma na liście autora | brak danych w katalogu | nie (na zamówienie) | 13.27 | 0.9 | 19 | screwdriver_holder_wera_368_square_0_snapfix_X2D_PETG.3mf
P077-368-SQ00 | Wera 368 kwadrat #00 | Wera | 368 | square | #00 |  | nie ma na liście autora | brak danych w katalogu | nie (na zamówienie) | 13.33 | 0.9 | 19 | screwdriver_holder_wera_368_square_00_snapfix_X2D_PETG.3mf
P077-368-SQ1 | Wera 368 kwadrat #1 | Wera | 368 | square | #1 |  | nie ma na liście autora | brak danych w katalogu | nie (na zamówienie) | 13.12 | 0.9 | 19 | screwdriver_holder_wera_368_square_1_snapfix_X2D_PETG.3mf
P077-368-SQ2 | Wera 368 kwadrat #2 | Wera | 368 | square | #2 |  | nie ma na liście autora | brak danych w katalogu | nie (na zamówienie) | 13.8 | 0.92 | 19 | screwdriver_holder_wera_368_square_2_snapfix_X2D_PETG.3mf
P077-368-SQ3 | Wera 368 kwadrat #3 | Wera | 368 | square | #3 |  | nie ma na liście autora | brak danych w katalogu | nie (na zamówienie) | 14.84 | 0.93 | 19 | screwdriver_holder_wera_368_square_3_snapfix_X2D_PETG.3mf
P077-368-SQ4 | Wera 368 kwadrat #4 | Wera | 368 | square | #4 |  | nie ma na liście autora | brak danych w katalogu | nie (na zamówienie) | 14.83 | 0.93 | 19 | screwdriver_holder_wera_368_square_4_snapfix_X2D_PETG.3mf
P077-391-NUT6 | Wera 391 nasadka 6 mm | Wera | 391 | nasadka | 6 |  | przetestowany przez autora | brak danych w katalogu | tak | 13.9 | 0.92 | 19 | screwdriver_holder_wera_391_nut_60_snapfix_X2D_PETG.3mf
P077-391-NUT7 | Wera 391 nasadka 7 mm | Wera | 391 | nasadka | 7 |  | przetestowany przez autora | brak danych w katalogu | tak | 13.9 | 0.92 | 19 | screwdriver_holder_wera_391_nut_70_snapfix_X2D_PETG.3mf
P077-391-NUT8 | Wera 391 nasadka 8 mm | Wera | 391 | nasadka | 8 |  | przetestowany przez autora | brak danych w katalogu | tak | 13.9 | 0.92 | 19 | screwdriver_holder_wera_391_nut_80_snapfix_X2D_PETG.3mf
P077-392 | Wera 392 | Wera | 392 |  |  |  | nie ma na liście autora | nie dotyczy | nie (na zamówienie) | 14.77 | 0.92 | 19 | screwdriver_holder_wera_392_snapfix_X2D_PETG.3mf
P077-393S | Wera 393S | Wera | 393S |  |  |  | przetestowany przez autora | nie dotyczy | tak | 14.77 | 0.92 | 19 | screwdriver_holder_wera_393S_snapfix_X2D_PETG.3mf
P077-395-NUT10 | Wera 395 nasadka 10 mm | Wera | 395 | nasadka | 10 |  | nieprzetestowany (wymiary z katalogu Wera) | brak danych w katalogu | nie (na zamówienie) | 14.66 | 0.93 | 19 | screwdriver_holder_wera_395_nut_100_snapfix_X2D_PETG.3mf
P077-395-NUT13 | Wera 395 nasadka 13 mm | Wera | 395 | nasadka | 13 |  | nieprzetestowany (wymiary z katalogu Wera) | brak danych w katalogu | nie (na zamówienie) | 14.47 | 0.93 | 19 | screwdriver_holder_wera_395_nut_130_snapfix_X2D_PETG.3mf
P077-395-NUT5 | Wera 395 nasadka 5 mm | Wera | 395 | nasadka | 5 |  | nieprzetestowany (wymiary z katalogu Wera) | brak danych w katalogu | nie (na zamówienie) | 13.41 | 0.91 | 19 | screwdriver_holder_wera_395_nut_50_snapfix_X2D_PETG.3mf
P077-395-NUT5-24-V2 | Wera 395 nasadka 5 mm (otwór 24 mm) | Wera | 395 | nasadka | 5 | v2 | wariant: otwór rękojeści 24 mm (nie ma na liście autora) | brak danych w katalogu | nie (na zamówienie) | 13.38 | 0.91 | 19 | screwdriver_holder_wera_395_nut_50_24mm_v2_snapfix_X2D_PETG.3mf
P077-395-NUT5.5 | Wera 395 nasadka 5.5 mm | Wera | 395 | nasadka | 5.5 |  | nieprzetestowany (wymiary z katalogu Wera) | brak danych w katalogu | nie (na zamówienie) | 13.42 | 0.91 | 19 | screwdriver_holder_wera_395_nut_55_snapfix_X2D_PETG.3mf
P077-395-NUT5.5-24-V2 | Wera 395 nasadka 5.5 mm (otwór 24 mm) | Wera | 395 | nasadka | 5.5 | v2 | wariant: otwór rękojeści 24 mm (nie ma na liście autora) | brak danych w katalogu | nie (na zamówienie) | 13.39 | 0.91 | 19 | screwdriver_holder_wera_395_nut_55_24mm_v2_snapfix_X2D_PETG.3mf
P077-395-NUT6 | Wera 395 nasadka 6 mm | Wera | 395 | nasadka | 6 |  | nieprzetestowany (wymiary z katalogu Wera) | brak danych w katalogu | nie (na zamówienie) | 13.41 | 0.91 | 19 | screwdriver_holder_wera_395_nut_60_snapfix_X2D_PETG.3mf
P077-395-NUT6-24-V2 | Wera 395 nasadka 6 mm (otwór 24 mm) | Wera | 395 | nasadka | 6 | v2 | wariant: otwór rękojeści 24 mm (nie ma na liście autora) | brak danych w katalogu | nie (na zamówienie) | 13.37 | 0.91 | 19 | screwdriver_holder_wera_395_nut_60_24mm_v2_snapfix_X2D_PETG.3mf
P077-395-NUT7 | Wera 395 nasadka 7 mm | Wera | 395 | nasadka | 7 |  | nieprzetestowany (wymiary z katalogu Wera) | brak danych w katalogu | nie (na zamówienie) | 13.69 | 0.92 | 19 | screwdriver_holder_wera_395_nut_70_snapfix_X2D_PETG.3mf
P077-395-NUT8 | Wera 395 nasadka 8 mm | Wera | 395 | nasadka | 8 |  | nieprzetestowany (wymiary z katalogu Wera) | brak danych w katalogu | nie (na zamówienie) | 13.49 | 0.92 | 19 | screwdriver_holder_wera_395_nut_80_snapfix_X2D_PETG.3mf
P077-811-1 | Wera 811/1 | Wera | 811/1 |  |  |  | nie ma na liście autora | nie dotyczy | nie (na zamówienie) | 14.04 | 0.93 | 19 | screwdriver_holder_wera_811_1_snapfix_X2D_PETG.3mf
P077-812-1 | Wera 812/1 | Wera | 812/1 |  |  |  | przetestowany przez autora | nie dotyczy | tak | 14.68 | 0.93 | 19 | screwdriver_holder_wera_812_1_snapfix_X2D_PETG.3mf
P077-816-RA | Wera 816 RA | Wera | 816 |  | RA |  | nie ma na liście autora | nie dotyczy | nie (na zamówienie) | 14.7 | 0.93 | 19 | screwdriver_holder_wera_816_ra_snapfix_X2D_PETG.3mf
P077-917-PH1 | Wera 917 PH1 | Wera | 917 | PH | 1 |  | przetestowany przez autora | brak danych w katalogu | tak | 13.81 | 0.92 | 19 | screwdriver_holder_wera_917_ph_1_snapfix_X2D_PETG.3mf
P077-917-PH2 | Wera 917 PH2 | Wera | 917 | PH | 2 |  | przetestowany przez autora | brak danych w katalogu | tak | 13.52 | 0.92 | 19 | screwdriver_holder_wera_917_ph_2_snapfix_X2D_PETG.3mf
P077-917-PH3 | Wera 917 PH3 | Wera | 917 | PH | 3 |  | przetestowany przez autora | brak danych w katalogu | tak | 14.51 | 0.93 | 19 | screwdriver_holder_wera_917_ph_3_snapfix_X2D_PETG.3mf | tak – wybrać jeden przed wystawieniem
P077-917-PH3-V2 | Wera 917 PH3 | Wera | 917 | PH | 3 | v2 | przetestowany przez autora | brak danych w katalogu | tak | 14.51 | 0.93 | 19 | screwdriver_holder_wera_917_ph_3_v2_snapfix_X2D_PETG.3mf | tak – wybrać jeden przed wystawieniem
P077-917-PH4-V2 | Wera 917 PH4 | Wera | 917 | PH | 4 | v2 | nie ma na liście autora | brak danych w katalogu | nie (na zamówienie) | 14.37 | 0.94 | 19 | screwdriver_holder_wera_917_ph_4_v2_snapfix_X2D_PETG.3mf
P077-918-PZ1 | Wera 918 PZ1 | Wera | 918 | PZ | 1 |  | przetestowany przez autora | brak danych w katalogu | tak | 13.81 | 0.92 | 19 | screwdriver_holder_wera_918_pz_1_snapfix_X2D_PETG.3mf
P077-918-PZ2 | Wera 918 PZ2 | Wera | 918 | PZ | 2 |  | przetestowany przez autora | brak danych w katalogu | tak | 13.52 | 0.92 | 19 | screwdriver_holder_wera_918_pz_2_snapfix_X2D_PETG.3mf
P077-918-PZ3 | Wera 918 PZ3 | Wera | 918 | PZ | 3 |  | przetestowany przez autora | brak danych w katalogu | tak | 14.48 | 0.93 | 19 | screwdriver_holder_wera_918_pz_3_snapfix_X2D_PETG.3mf
P077-918-PZ4-V2 | Wera 918 PZ4 | Wera | 918 | PZ | 4 | v2 | nie ma na liście autora | brak danych w katalogu | nie (na zamówienie) | 14.38 | 0.94 | 19 | screwdriver_holder_wera_918_pz_4_v2_snapfix_X2D_PETG.3mf
P077-932A-FL10 | Wera 932A płaski 10 mm | Wera | 932A | flat | 10 |  | przetestowany przez autora | brak danych w katalogu | tak | 14.49 | 0.93 | 19 | screwdriver_holder_wera_932A_flat_100_snapfix_X2D_PETG.3mf | tak – wybrać jeden przed wystawieniem
P077-932A-FL10-V2 | Wera 932A płaski 10 mm | Wera | 932A | flat | 10 | v2 | przetestowany przez autora | brak danych w katalogu | tak | 14.5 | 0.93 | 19 | screwdriver_holder_wera_932A_flat_100_v2_snapfix_X2D_PETG.3mf | tak – wybrać jeden przed wystawieniem
P077-932A-FL12-V2 | Wera 932A płaski 12 mm | Wera | 932A | flat | 12 | v2 | nie ma na liście autora | brak danych w katalogu | nie (na zamówienie) | 14.36 | 0.93 | 19 | screwdriver_holder_wera_932A_flat_120_v2_snapfix_X2D_PETG.3mf
P077-932A-FL14-V2 | Wera 932A płaski 14 mm | Wera | 932A | flat | 14 | v2 | nie ma na liście autora | brak danych w katalogu | nie (na zamówienie) | 14.36 | 0.93 | 19 | screwdriver_holder_wera_932A_flat_140_v2_snapfix_X2D_PETG.3mf
P077-932A-FL3.5 | Wera 932A płaski 3.5 mm | Wera | 932A | flat | 3.5 |  | nieprzetestowany (wymiary z katalogu Wera) | brak danych w katalogu | nie (na zamówienie) | 13.07 | 0.89 | 19 | screwdriver_holder_wera_932A_flat_35_snapfix_X2D_PETG.3mf
P077-932A-FL4.5 | Wera 932A płaski 4.5 mm | Wera | 932A | flat | 4.5 |  | nieprzetestowany (wymiary z katalogu Wera) | brak danych w katalogu | nie (na zamówienie) | 13.81 | 0.92 | 19 | screwdriver_holder_wera_932A_flat_45_snapfix_X2D_PETG.3mf
P077-932A-FL5.5 | Wera 932A płaski 5.5 mm | Wera | 932A | flat | 5.5 |  | przetestowany przez autora | brak danych w katalogu | tak | 13.48 | 0.92 | 19 | screwdriver_holder_wera_932A_flat_55_snapfix_X2D_PETG.3mf
P077-932A-FL7 | Wera 932A płaski 7 mm | Wera | 932A | flat | 7 |  | przetestowany przez autora | brak danych w katalogu | tak | 13.48 | 0.92 | 19 | screwdriver_holder_wera_932A_flat_70_snapfix_X2D_PETG.3mf
P077-932A-FL9 | Wera 932A płaski 9 mm | Wera | 932A | flat | 9 |  | nie ma na liście autora | brak danych w katalogu | nie (na zamówienie) | 14.5 | 0.93 | 19 | screwdriver_holder_wera_932A_flat_90_snapfix_X2D_PETG.3mf | tak – wybrać jeden przed wystawieniem
P077-932A-FL9-V2 | Wera 932A płaski 9 mm | Wera | 932A | flat | 9 | v2 | nie ma na liście autora | brak danych w katalogu | nie (na zamówienie) | 14.5 | 0.93 | 19 | screwdriver_holder_wera_932A_flat_90_v2_snapfix_X2D_PETG.3mf | tak – wybrać jeden przed wystawieniem
P077-977-TX20 | Wera 977 TX20 | Wera | 977 | TX | 20 |  | nieprzetestowany (wymiary z katalogu Wera) | brak danych w katalogu | nie (na zamówienie) | 13.83 | 0.92 | 19 | screwdriver_holder_wera_977_tx_20_snapfix_X2D_PETG.3mf
P077-977-TX25 | Wera 977 TX25 | Wera | 977 | TX | 25 |  | nieprzetestowany (wymiary z katalogu Wera) | brak danych w katalogu | nie (na zamówienie) | 13.53 | 0.92 | 19 | screwdriver_holder_wera_977_tx_25_snapfix_X2D_PETG.3mf
