patryk-homelab/ClaudeRepo/credits-3d/01_1770956_bit-holder-organizer_Jirka/oryginal/Bit_holder,_organizer.3mf

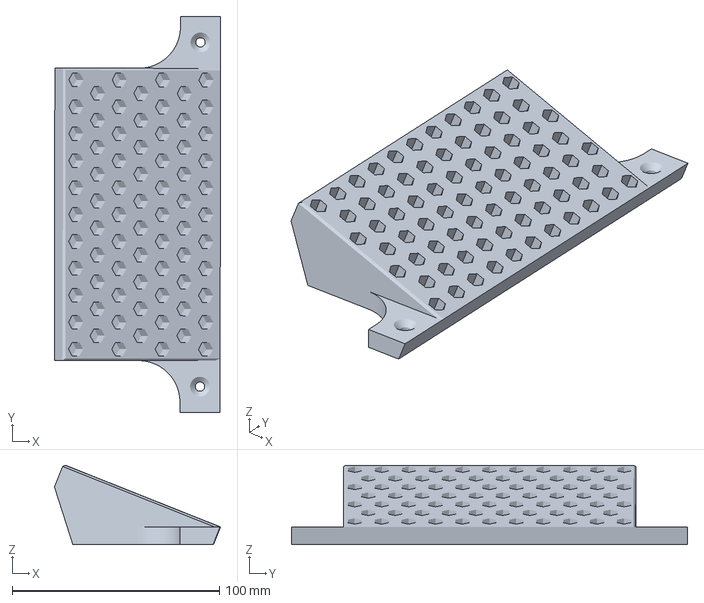
[picture p13: CAD file, 2026-11-04]
credits-3d/01_1770956_bit-holder-organizer_Jirka/oryginal/Bit_holder,_organizer.3mf
80.2 x 191.2 x 38.3 mm
