patryk-homelab/ClaudeRepo/credits-3d/02_1825701_large-bit-holder_Jirka/oryginal/Large_bit_holder_(176_pieces).3mf

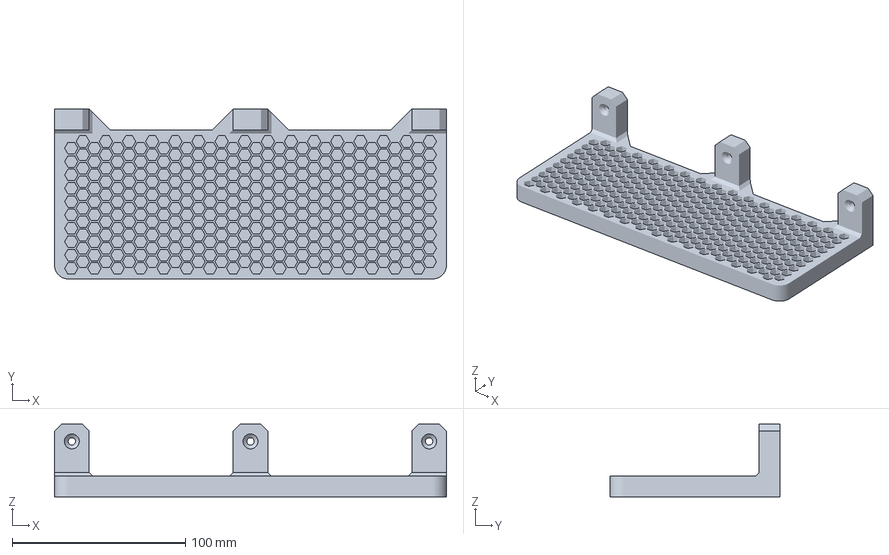
[picture p14: CAD file, 2026-11-04]
credits-3d/02_1825701_large-bit-holder_Jirka/oryginal/Large_bit_holder_(176_pieces).3mf
226.0 x 98.0 x 42.0 mm
