patryk-homelab/ClaudeRepo/credits-3d/04_146076_hex-bit-holder_GUZ_prints/oryginal/hex_bit_holder_v2.stl

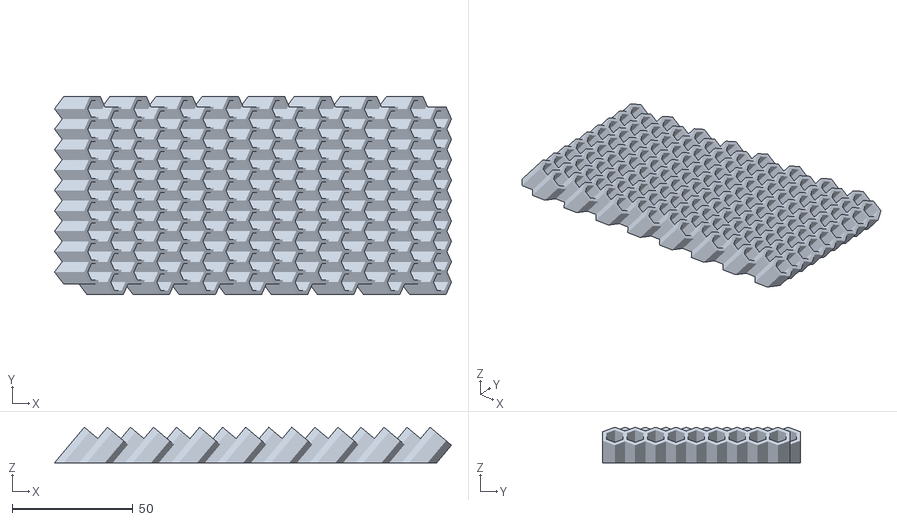
[picture p15: CAD file, 2026-11-04]
credits-3d/04_146076_hex-bit-holder_GUZ_prints/oryginal/hex_bit_holder_v2.stl
164.4 x 81.8 x 14.7
