patryk-homelab/ClaudeRepo/credits-3d/04_146076_hex-bit-holder_GUZ_prints/poprawiony/hex_bit_holder_v1_mounting_ears_X2D_PETG.3mf

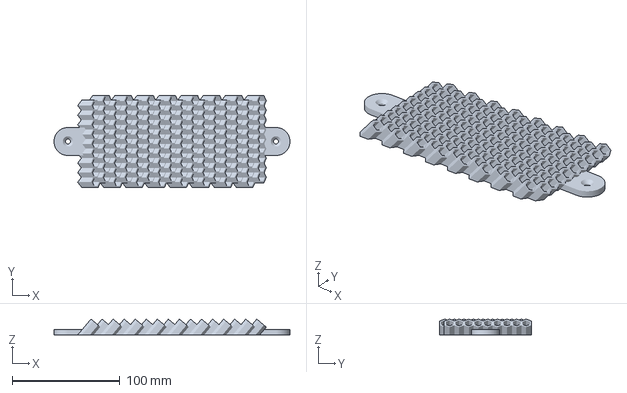
[picture p16: CAD file, 2026-11-04]
credits-3d/04_146076_hex-bit-holder_GUZ_prints/poprawiony/hex_bit_holder_v1_mounting_ears_X2D_PETG.3mf
219.2 x 85.6 x 14.7 mm
