patryk-homelab/ClaudeRepo/credits-3d/_wycofane_magnesy_2026-11-04/03_1051202_ultimate-bit-holder_CarlosGonzalez/oryginal/Divider_7.3mf

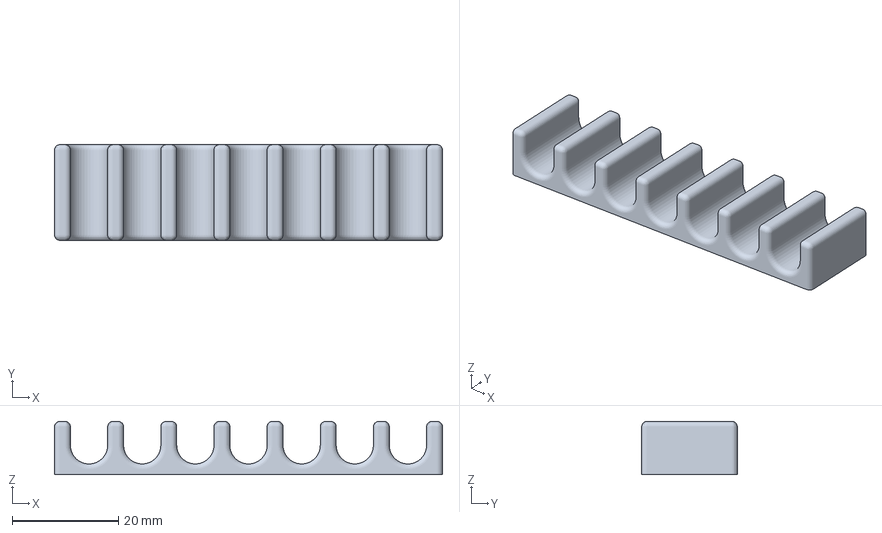
[picture p17: CAD file, 2026-11-04]
credits-3d/_wycofane_magnesy_2026-11-04/03_1051202_ultimate-bit-holder_CarlosGonzalez/oryginal/Divider_7.3mf
73.0 x 18.0 x 10.0 mm
