patryk-homelab/ClaudeRepo/credits-3d/_wycofane_magnesy_2026-11-04/03_1051202_ultimate-bit-holder_CarlosGonzalez/poprawiony/bar_magnet_frame_60x10_clearance_0.2.3mf

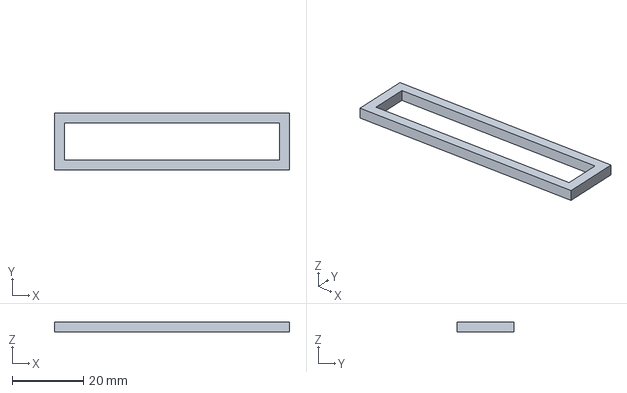
[picture p18: CAD file, 2026-11-04]
credits-3d/_wycofane_magnesy_2026-11-04/03_1051202_ultimate-bit-holder_CarlosGonzalez/poprawiony/bar_magnet_frame_60x10_clearance_0.2.3mf
66.0 x 16.0 x 2.80 mm
