patryk-homelab/ClaudeRepo/credits-3d/04_146076_hex-bit-holder_GUZ_prints/oryginal/hex_bit_holder.stl

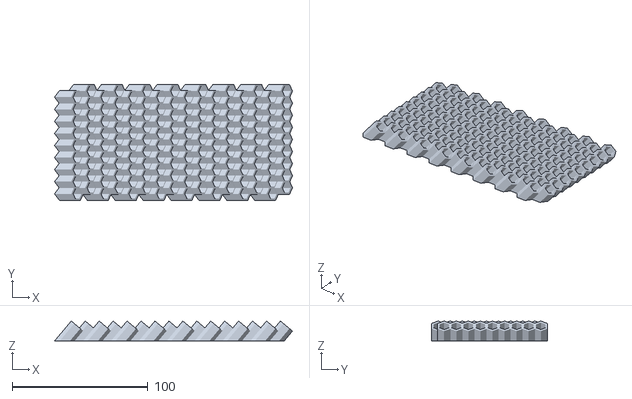
[picture p19: CAD file, 2026-11-04]
credits-3d/04_146076_hex-bit-holder_GUZ_prints/oryginal/hex_bit_holder.stl
175.2 x 85.6 x 14.7
