patryk-homelab/ClaudeRepo/credits-3d/_wycofane_magnesy_2026-11-04/03_1051202_ultimate-bit-holder_CarlosGonzalez/oryginal/MAGNETIC_BIT_HOLDER.stl

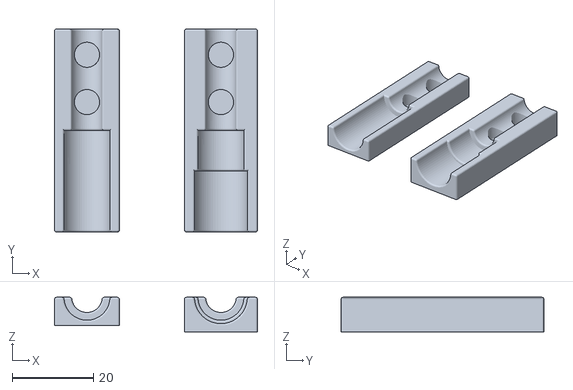
[picture p20: CAD file, 2026-11-04]
credits-3d/_wycofane_magnesy_2026-11-04/03_1051202_ultimate-bit-holder_CarlosGonzalez/oryginal/MAGNETIC_BIT_HOLDER.stl
50.0 x 50.0 x 8.50
