patryk-homelab/ClaudeRepo/credits-3d/_wycofane_magnesy_2026-11-04/03_1051202_ultimate-bit-holder_CarlosGonzalez/poprawiony/3x7_hex_bit_holder_angled_repaired_X2D_PETG.3mf

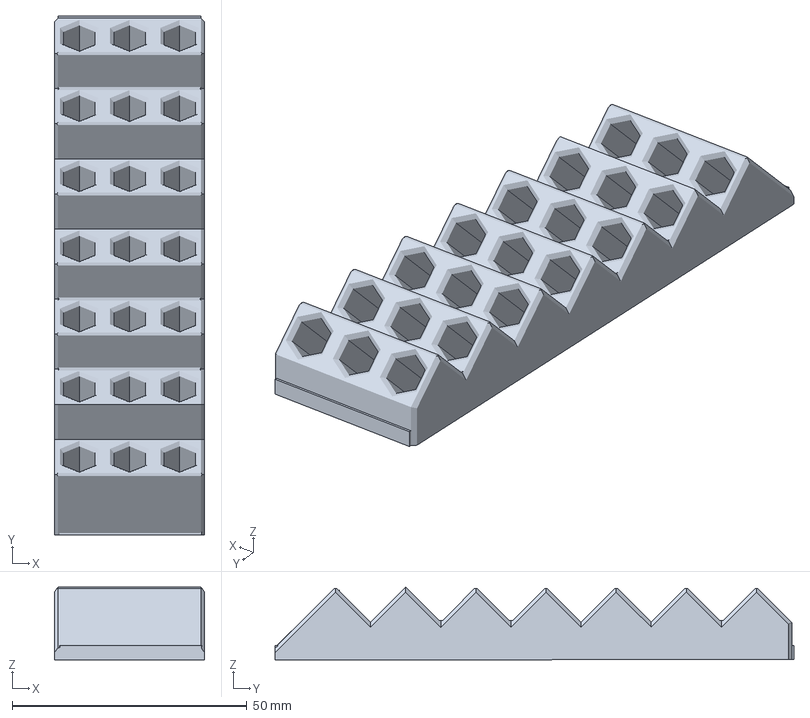
[picture p21: CAD file, 2026-11-04]
credits-3d/_wycofane_magnesy_2026-11-04/03_1051202_ultimate-bit-holder_CarlosGonzalez/poprawiony/3x7_hex_bit_holder_angled_repaired_X2D_PETG.3mf
32.0 x 110.5 x 15.5 mm
