patryk-homelab/ClaudeRepo/credits-3d/_wycofane_magnesy_2026-11-04/03_1051202_ultimate-bit-holder_CarlosGonzalez/projekt_X2D/SMALL_DIVIDER_2_ENLARGED__X2D_PETG.3mf

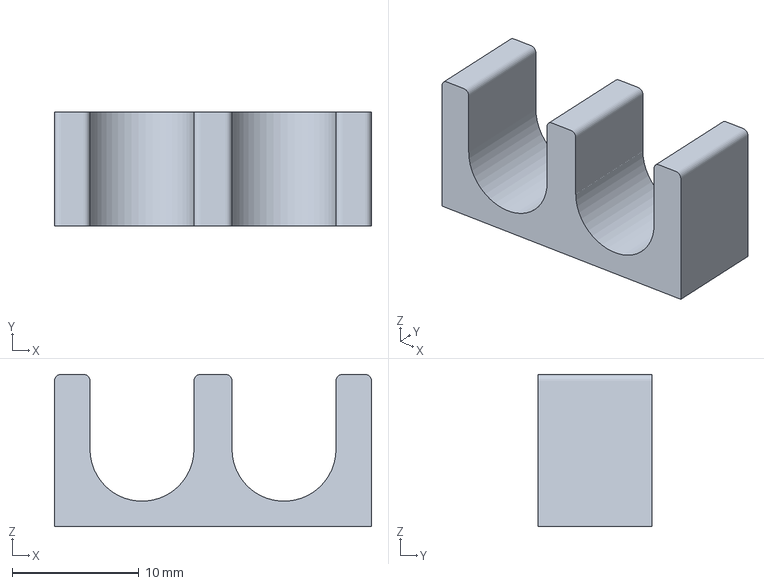
[picture p22: CAD file, 2026-11-04]
credits-3d/_wycofane_magnesy_2026-11-04/03_1051202_ultimate-bit-holder_CarlosGonzalez/projekt_X2D/SMALL_DIVIDER_2_ENLARGED__X2D_PETG.3mf
25.0 x 9.00 x 12.0 mm
