patryk-homelab/ClaudeRepo/credits-3d/04_146076_hex-bit-holder_GUZ_prints/oryginal/single_unit_hex_bit.stp

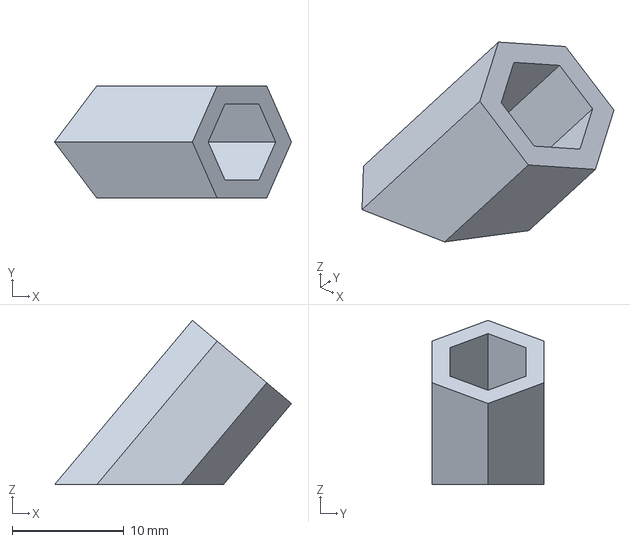
[picture p23: CAD file, 2026-11-04]
credits-3d/04_146076_hex-bit-holder_GUZ_prints/oryginal/single_unit_hex_bit.stp
21.2 x 10.0 x 14.7 mm
