patryk-homelab/ClaudeRepo/credits-3d/_wycofane_magnesy_2026-11-04/03_1051202_ultimate-bit-holder_CarlosGonzalez/projekt_X2D/DIVIDER_5_X2D_PETG.3mf

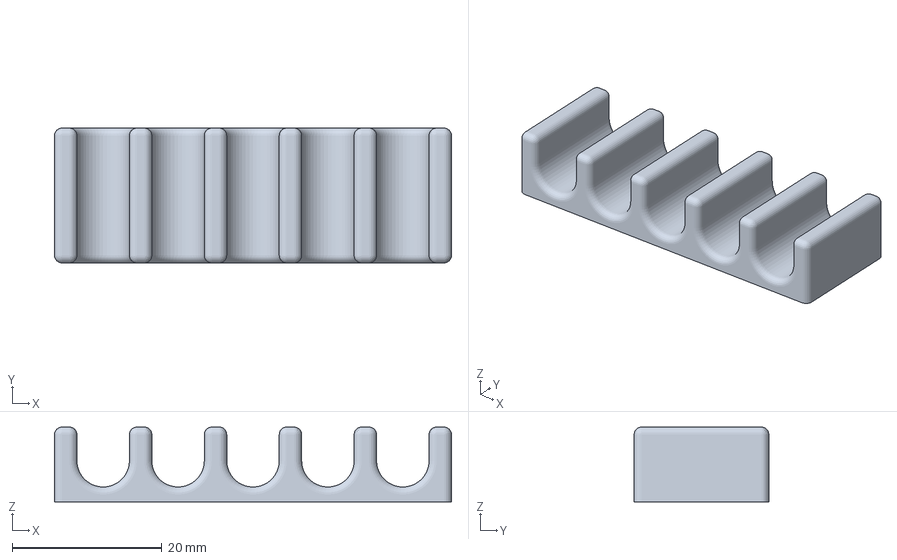
[picture p25: CAD file, 2026-11-04]
credits-3d/_wycofane_magnesy_2026-11-04/03_1051202_ultimate-bit-holder_CarlosGonzalez/projekt_X2D/DIVIDER_5_X2D_PETG.3mf
53.0 x 18.0 x 10.0 mm
