patryk-homelab/ClaudeRepo/credits-3d/_wycofane_magnesy_2026-11-04/03_1051202_ultimate-bit-holder_CarlosGonzalez/oryginal/RIGHT_ANGLE_ATTACHMENT_HOLDER.stl

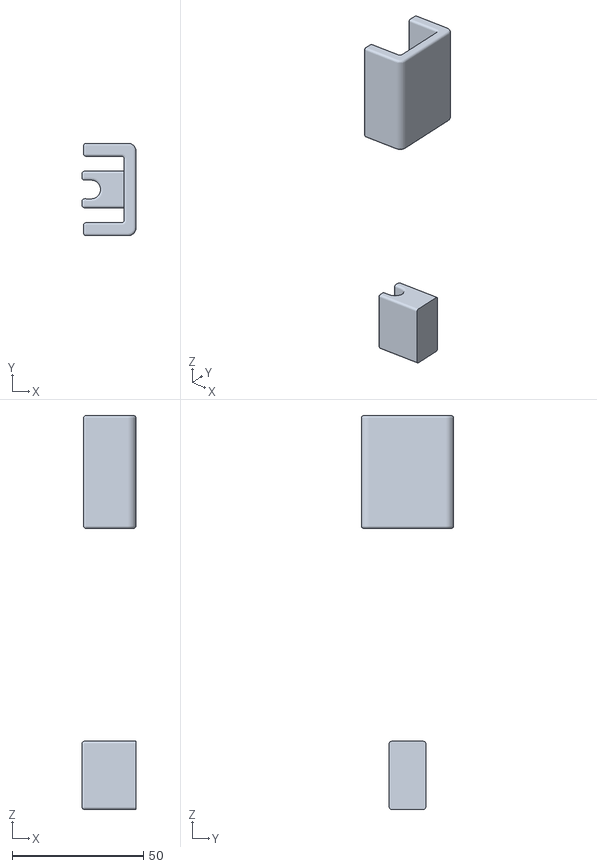
[picture p26: CAD file, 2026-11-04]
credits-3d/_wycofane_magnesy_2026-11-04/03_1051202_ultimate-bit-holder_CarlosGonzalez/oryginal/RIGHT_ANGLE_ATTACHMENT_HOLDER.stl
20.6 x 35.2 x 150.0
