patryk-homelab/ClaudeRepo/credits-3d/_wycofane_magnesy_2026-11-04/03_1051202_ultimate-bit-holder_CarlosGonzalez/oryginal/socket_extension_holder_v2.stl

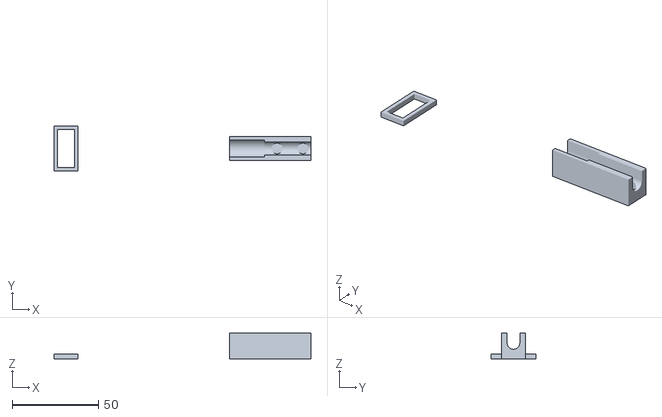
[picture p30: CAD file, 2026-11-04]
credits-3d/_wycofane_magnesy_2026-11-04/03_1051202_ultimate-bit-holder_CarlosGonzalez/oryginal/socket_extension_holder_v2.stl
148.6 x 26.0 x 14.8
