patryk-homelab/ClaudeRepo/credits-3d/_wycofane_magnesy_2026-11-04/03_1051202_ultimate-bit-holder_CarlosGonzalez/oryginal/8x4_hex_bit_holder_angled.3mf

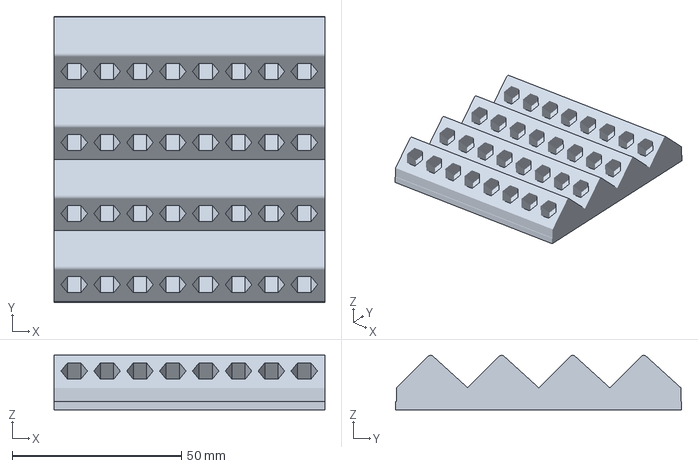
[picture p31: CAD file, 2026-11-04]
credits-3d/_wycofane_magnesy_2026-11-04/03_1051202_ultimate-bit-holder_CarlosGonzalez/oryginal/8x4_hex_bit_holder_angled.3mf
80.0 x 84.5 x 16.1 mm
