patryk-homelab/ClaudeRepo/credits-3d/_wycofane_magnesy_2026-11-04/03_1051202_ultimate-bit-holder_CarlosGonzalez/projekt_X2D/SINGLE_HOLDER_FOR_COIN_MAGNET_X2D_PETG.3mf

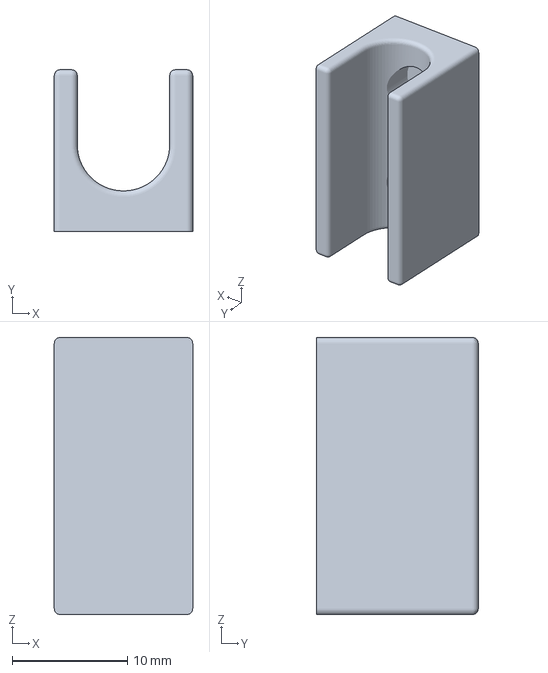
[picture p32: CAD file, 2026-11-04]
credits-3d/_wycofane_magnesy_2026-11-04/03_1051202_ultimate-bit-holder_CarlosGonzalez/projekt_X2D/SINGLE_HOLDER_FOR_COIN_MAGNET_X2D_PETG.3mf
12.0 x 14.0 x 24.0 mm
