patryk-homelab/ClaudeRepo/credits-3d/_wycofane_magnesy_2026-11-04/03_1051202_ultimate-bit-holder_CarlosGonzalez/oryginal/DIVIDERS_AND_COIN_MAGNET_HOLDER.stl

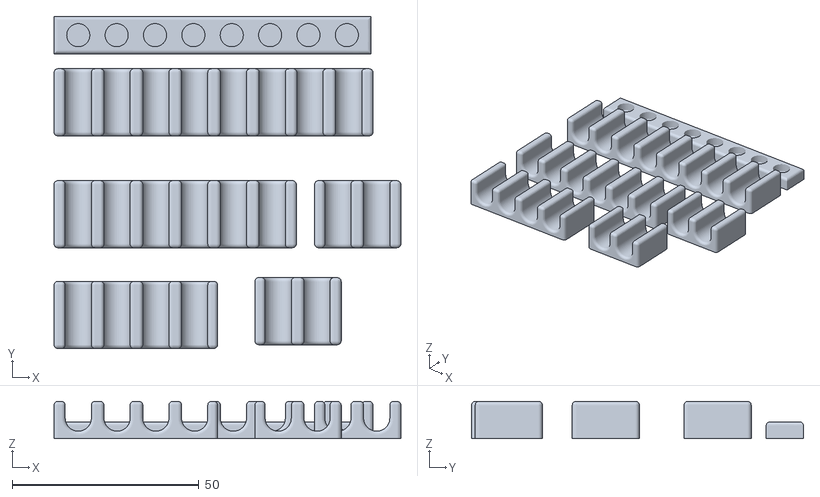
[picture p33: CAD file, 2026-11-04]
credits-3d/_wycofane_magnesy_2026-11-04/03_1051202_ultimate-bit-holder_CarlosGonzalez/oryginal/DIVIDERS_AND_COIN_MAGNET_HOLDER.stl
93.0 x 89.0 x 10.0
