patryk-homelab/ClaudeRepo/credits-3d/_wycofane_magnesy_2026-11-04/03_1051202_ultimate-bit-holder_CarlosGonzalez/oryginal/SELF-CENTERING_BIT_DIVIDER3_COIN_MAGNET.stl

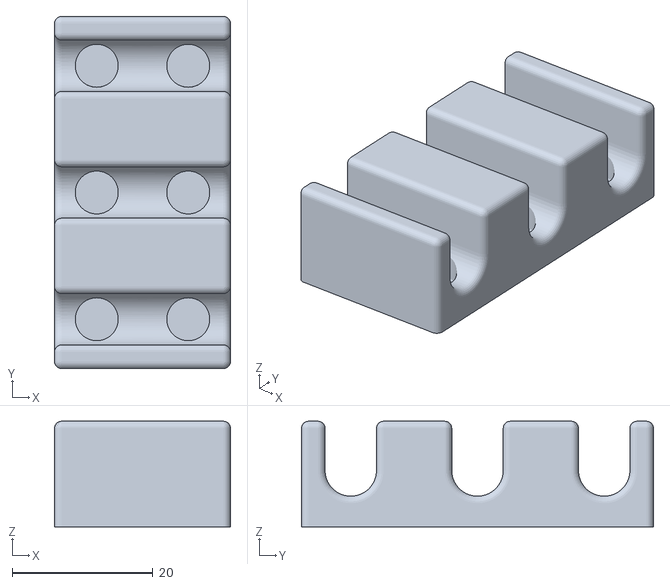
[picture p34: CAD file, 2026-11-04]
credits-3d/_wycofane_magnesy_2026-11-04/03_1051202_ultimate-bit-holder_CarlosGonzalez/oryginal/SELF-CENTERING_BIT_DIVIDER3_COIN_MAGNET.stl
25.0 x 50.0 x 15.0
