patryk-homelab/ClaudeRepo/credits-3d/_wycofane_magnesy_2026-11-04/03_1051202_ultimate-bit-holder_CarlosGonzalez/oryginal/BAR_MAGNET_FRAME_60X10.stl

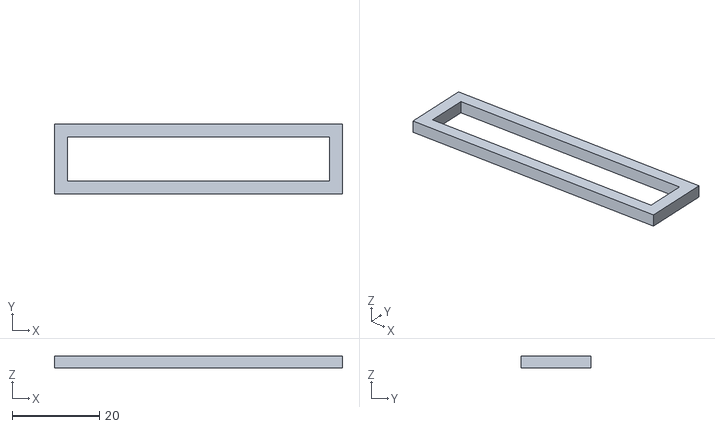
[picture p38: CAD file, 2026-11-04]
credits-3d/_wycofane_magnesy_2026-11-04/03_1051202_ultimate-bit-holder_CarlosGonzalez/oryginal/BAR_MAGNET_FRAME_60X10.stl
66.0 x 16.0 x 2.80
