patryk-homelab/ClaudeRepo/credits-3d/_wycofane_magnesy_2026-11-04/03_1051202_ultimate-bit-holder_CarlosGonzalez/oryginal/Bar_Magnet_Frame_60mmx10mm.3mf

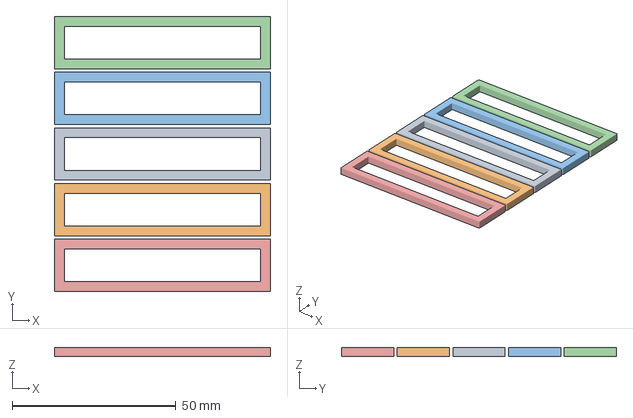
[picture p39: CAD file, 2026-11-04]
credits-3d/_wycofane_magnesy_2026-11-04/03_1051202_ultimate-bit-holder_CarlosGonzalez/oryginal/Bar_Magnet_Frame_60mmx10mm.3mf
66.0 x 84.0 x 2.80 mm
Body1.stl x 5
