patryk-homelab/ClaudeRepo/(list of files, cad)

Other CAD files:
credits-3d/01_1770956_bit-holder-organizer_Jirka/projekt_X2D/Bit_holder_organizer_1770956_X2D_PETG.3mf
credits-3d/02_1825701_large-bit-holder_Jirka/poprawiony/Large_bit_holder_320_fixed_X2D_PETG.3mf
credits-3d/02_1825701_large-bit-holder_Jirka/poprawiony/Large_bit_holder_320_fixed.3mf
credits-3d/04_146076_hex-bit-holder_GUZ_prints/poprawiony/hex_bit_holder_v1_mounting_ears.3mf
credits-3d/_wycofane_magnesy_2026-11-04/03_1051202_ultimate-bit-holder_CarlosGonzalez/poprawiony/MAGNETIC_BIT_HOLDER_na_stole_X2D_PETG.3mf
credits-3d/_wycofane_magnesy_2026-11-04/03_1051202_ultimate-bit-holder_CarlosGonzalez/oryginal/Vertical_3x7_Hex_Bit_Holder_Angled.3mf
credits-3d/_wycofane_magnesy_2026-11-04/03_1051202_ultimate-bit-holder_CarlosGonzalez/poprawiony/bar_magnet_frame_60x10_clearance_0.2_X2D_PETG.3mf
credits-3d/_wycofane_magnesy_2026-11-04/03_1051202_ultimate-bit-holder_CarlosGonzalez/oryginal/Divider_2_Slightly_Bigger_for_larger_bits.3mf
credits-3d/_wycofane_magnesy_2026-11-04/03_1051202_ultimate-bit-holder_CarlosGonzalez/poprawiony/MAGNETIC_BIT_HOLDER_na_stole.3mf
credits-3d/_wycofane_magnesy_2026-11-04/03_1051202_ultimate-bit-holder_CarlosGonzalez/poprawiony/3x7_hex_bit_holder_angled_repaired.3mf
credits-3d/_wycofane_magnesy_2026-11-04/03_1051202_ultimate-bit-holder_CarlosGonzalez/projekt_X2D/Dewalt_90_degree_adapter_holder_v3_X2D_PETG.3mf
credits-3d/_wycofane_magnesy_2026-11-04/03_1051202_ultimate-bit-holder_CarlosGonzalez/poprawiony/8x4_hex_bit_holder_angled_repaired.3mf
credits-3d/_wycofane_magnesy_2026-11-04/03_1051202_ultimate-bit-holder_CarlosGonzalez/projekt_X2D/socket_extension_holder_v2_X2D_PETG.3mf
credits-3d/_wycofane_magnesy_2026-11-04/03_1051202_ultimate-bit-holder_CarlosGonzalez/projekt_X2D/DIVIDER_2_X2D_PETG.3mf
credits-3d/_wycofane_magnesy_2026-11-04/03_1051202_ultimate-bit-holder_CarlosGonzalez/oryginal/SMALL_DIVIDER_2_ENLARGED_.stl
credits-3d/_wycofane_magnesy_2026-11-04/03_1051202_ultimate-bit-holder_CarlosGonzalez/oryginal/3x7_hex_bit_holder_angled.stl
credits-3d/_wycofane_magnesy_2026-11-04/03_1051202_ultimate-bit-holder_CarlosGonzalez/projekt_X2D/SELF-CENTERING_BIT_DIVIDER3_COIN_MAGNET_X2D_PETG.3mf
credits-3d/_wycofane_magnesy_2026-11-04/03_1051202_ultimate-bit-holder_CarlosGonzalez/oryginal/socket_extension_holder_with_small_magnet_frame_v2.3mf
credits-3d/_wycofane_magnesy_2026-11-04/03_1051202_ultimate-bit-holder_CarlosGonzalez/projekt_X2D/DIVIDER_7_X2D_PETG.3mf
credits-3d/_wycofane_magnesy_2026-11-04/03_1051202_ultimate-bit-holder_CarlosGonzalez/oryginal/SINGLE_HOLDER_FOR_COIN_MAGNET.stl
credits-3d/_wycofane_magnesy_2026-11-04/03_1051202_ultimate-bit-holder_CarlosGonzalez/oryginal/Divider_4.3mf
credits-3d/_wycofane_magnesy_2026-11-04/03_1051202_ultimate-bit-holder_CarlosGonzalez/oryginal/Divider_8.3mf
credits-3d/_wycofane_magnesy_2026-11-04/03_1051202_ultimate-bit-holder_CarlosGonzalez/oryginal/Divider_3.3mf
credits-3d/_wycofane_magnesy_2026-11-04/03_1051202_ultimate-bit-holder_CarlosGonzalez/oryginal/Divider_6.3mf
credits-3d/_wycofane_magnesy_2026-11-04/03_1051202_ultimate-bit-holder_CarlosGonzalez/oryginal/Divider_5.3mf
credits-3d/_wycofane_magnesy_2026-11-04/03_1051202_ultimate-bit-holder_CarlosGonzalez/oryginal/Divider_1.3mf
credits-3d/_wycofane_magnesy_2026-11-04/03_1051202_ultimate-bit-holder_CarlosGonzalez/oryginal/HEX_BIT_Extension_HOLDERs_v3.3mf
credits-3d/_wycofane_magnesy_2026-11-04/03_1051202_ultimate-bit-holder_CarlosGonzalez/oryginal/Bore_Bit_Holder.3mf
credits-3d/_wycofane_magnesy_2026-11-04/03_1051202_ultimate-bit-holder_CarlosGonzalez/oryginal/Dewalt_90_degree_adapter_holder_v3.3mf
credits-3d/wkretaki/04_123412_wera-screwdriver-holder_ksuszka/oryginal/wera_screwdriver_holder_v3.scad
credits-3d/wkretaki/04_123412_wera-screwdriver-holder_ksuszka/poprawiony/wera_screwdriver_holder_v3_snapfix.scad
credits-3d/wkretaki/04_123412_wera-screwdriver-holder_ksuszka/oryginal/wera_screwdriver_holder_v1.scad
credits-3d/01_1770956_bit-holder-organizer_Jirka/oryginal/Bit_holder,_organizer.stl
credits-3d/02_1825701_large-bit-holder_Jirka/oryginal/Large_bit_holder_(176_pieces).stl
credits-3d/_wycofane_magnesy_2026-11-04/03_1051202_ultimate-bit-holder_CarlosGonzalez/oryginal/8x4_hex_bit_holder_angled.stl
credits-3d/_wycofane_magnesy_2026-11-04/03_1051202_ultimate-bit-holder_CarlosGonzalez/oryginal/Amana_Countersunk_Screw_Bit_Holder.3mf
credits-3d/_wycofane_magnesy_2026-11-04/03_1051202_ultimate-bit-holder_CarlosGonzalez/oryginal/Amana_Countersunk_Screw_Bit_Holder.stl
credits-3d/_wycofane_magnesy_2026-11-04/03_1051202_ultimate-bit-holder_CarlosGonzalez/oryginal/DIVIDERS_1-8.stl
credits-3d/_wycofane_magnesy_2026-11-04/03_1051202_ultimate-bit-holder_CarlosGonzalez/oryginal/DIVIDER_1.stl
credits-3d/_wycofane_magnesy_2026-11-04/03_1051202_ultimate-bit-holder_CarlosGonzalez/oryginal/DIVIDER_2.stl
credits-3d/_wycofane_magnesy_2026-11-04/03_1051202_ultimate-bit-holder_CarlosGonzalez/oryginal/DIVIDER_3.stl
credits-3d/_wycofane_magnesy_2026-11-04/03_1051202_ultimate-bit-holder_CarlosGonzalez/oryginal/DIVIDER_4.stl
credits-3d/_wycofane_magnesy_2026-11-04/03_1051202_ultimate-bit-holder_CarlosGonzalez/oryginal/DIVIDER_5.stl
credits-3d/_wycofane_magnesy_2026-11-04/03_1051202_ultimate-bit-holder_CarlosGonzalez/oryginal/DIVIDER_6.stl
credits-3d/_wycofane_magnesy_2026-11-04/03_1051202_ultimate-bit-holder_CarlosGonzalez/oryginal/DIVIDER_7.stl
credits-3d/_wycofane_magnesy_2026-11-04/03_1051202_ultimate-bit-holder_CarlosGonzalez/oryginal/DIVIDER_8.stl
credits-3d/_wycofane_magnesy_2026-11-04/03_1051202_ultimate-bit-holder_CarlosGonzalez/oryginal/screw_head_labels_v2.3mf
credits-3d/_wycofane_magnesy_2026-11-04/03_1051202_ultimate-bit-holder_CarlosGonzalez/oryginal/screw_head_labels_v2.stl
credits-3d/_wycofane_magnesy_2026-11-04/03_1051202_ultimate-bit-holder_CarlosGonzalez/projekt_X2D/Amana_Countersunk_Screw_Bit_Holder_X2D_PETG.3mf
credits-3d/_wycofane_magnesy_2026-11-04/03_1051202_ultimate-bit-holder_CarlosGonzalez/projekt_X2D/screw_head_labels_v2_X2D_PETG.3mf
credits-3d/_wycofane_magnesy_2026-11-04/wkretaki/04_123412_wera-screwdriver-holder_ksuszka/oryginal/screwdriver_holder_rail_200mm_magnets_10x3mm.stl
credits-3d/_wycofane_magnesy_2026-11-04/wkretaki/04_123412_wera-screwdriver-holder_ksuszka/poprawiony/szyny/screwdriver_holder_rail_200mm_magnets_10x3mm_X2D_PETG.3mf
credits-3d/wkretaki/01_1808383_large-screwdriver-holder-honeycomb_Jirka/oryginal/Large_screwdriver_holder_with_honeycomb_pattern.3mf
credits-3d/wkretaki/01_1808383_large-screwdriver-holder-honeycomb_Jirka/oryginal/Large_screwdriver_holder_with_honeycomb_pattern.stl
credits-3d/wkretaki/01_1808383_large-screwdriver-holder-honeycomb_Jirka/poprawiony/screwdriver_holder_honeycomb_1808383_fixed.3mf
credits-3d/wkretaki/01_1808383_large-screwdriver-holder-honeycomb_Jirka/poprawiony/screwdriver_holder_honeycomb_1808383_fixed_X2D_PETG.3mf
credits-3d/wkretaki/02_1782552_large-massive-screwdriver-holder_Jirka/oryginal/Large_massive_screwdriver_holder.3mf
credits-3d/wkretaki/02_1782552_large-massive-screwdriver-holder_Jirka/oryginal/Large_massive_screwdriver_holder.stl
credits-3d/wkretaki/02_1782552_large-massive-screwdriver-holder_Jirka/poprawiony/massive_screwdriver_holder_1782552_fixed.3mf
credits-3d/wkretaki/02_1782552_large-massive-screwdriver-holder_Jirka/poprawiony/massive_screwdriver_holder_1782552_fixed_X2D_PETG.3mf
credits-3d/wkretaki/03_41393_ikea-skadis-screwdriver-holder_Pavel/oryginal/hook_skadis_universal.stl
credits-3d/wkretaki/03_41393_ikea-skadis-screwdriver-holder_Pavel/oryginal/screwdriver_big.FCStd
credits-3d/wkretaki/03_41393_ikea-skadis-screwdriver-holder_Pavel/oryginal/screwdriver_big.stl
credits-3d/wkretaki/03_41393_ikea-skadis-screwdriver-holder_Pavel/oryginal/screwdriver_small.FCStd
credits-3d/wkretaki/03_41393_ikea-skadis-screwdriver-holder_Pavel/oryginal/screwdriver_small.stl
credits-3d/wkretaki/03_41393_ikea-skadis-screwdriver-holder_Pavel/z_bryly_FreeCAD/hook_skadis_universal_41393_X2D_PETG.3mf
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
