patryk-homelab/ClaudeRepo/credits-3d/_wycofane_magnesy_2026-11-04/narzedzia/build123d_ramka_magnesu/README.txt

Nowa ramka magnesu 60 x 10 mm do 1051202. Kod jest uruchamiany przez build123d-mcp (execute + validate + analyze_printability + export),
wywołania w calls.json, klient: ../../wkretaki/narzedzia/client.py. Dwa przebiegi dają ten sam STL (sha256 23cbe45c…7bc5)
i ten sam 3D/3dmodel.model w 3MF po usunięciu CreationDate.
