patryk-homelab/ClaudeRepo/(commit log)

2026-11-04 Add credits-3d: four Printables bit holders checked with projekt-3d-druk
    Originals (CC0 x3, CC BY x1), licence/attribution notes, per-model reports,
    fixed 3MF files and the scripts used:
    - 1770956: passes all checks, printed as is
    - 1825701: widen 16 clipped front-row pockets, teardrop screw holes
    - 1051202: repair broken meshes of the 3x7 and 8x4 hex holders
    - 146076: add two mounting ears with countersunk holes
    Claude-Session: https://claude.ai/code/session_01Vui5Q4gn4uG8dhYNZhYdgK
    [3x7_hex_bit_holder_angled.stl, 3x7_hex_bit_holder_angled_repaired.3mf, 8x4_hex_bit_holder_angled.3mf, 8x4_hex_bit_holder_angled.stl, 8x4_hex_bit_holder_angled_repaired.3mf, Amana_Countersunk_Screw_Bit_Holder.3mf, Amana_Countersunk_Screw_Bit_Holder.stl, BAR_MAGNET_FRAME_60X10.stl]
2026-11-04 credits-3d: add four Printables screwdriver holders checked with projekt-3d-druk
    - 1808383 honeycomb shelf: refill the one hole widened from below
    (0.7 mm wall, needed support), recut as a regular 9.0 mm hole.
    - 1782552 massive shelf: complete 21 edge-clipped holes to full 8.0 mm.
    - 41393 SKADIS combs: export from the author's FreeCAD solid, no shape change.
    - 123412 Wera holders: 1 mm relief slot in the snap foot for all 140
    holders (bending strain ~6.4% -> ~1.5%), plus patched v3 .scad.
    - Bambu Studio X2D/PETG project files, reports, scripts, results and
    an interactive 3D fit preview.
    Claude-Session: https://claude.ai/code/sess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
    [Large_massive_screwdriver_holder.3mf, Large_massive_screwdriver_holder.stl, Large_screwdriver_holder_with_honeycomb_pattern.3mf, Large_screwdriver_holder_with_honeycomb_pattern.stl, hook_skadis_universal.stl, hook_skadis_universal_41393_X2D_PETG.3mf, ikea_skadis_screwdriver_comb_big_41393.3mf, ikea_skadis_screwdriver_comb_big_41393_X2D_PETG.3mf]
2026-11-04 credits-3d: bring bit holders to the screwdriver level of checks
    - Bambu Studio X2D slicing before/after and project 3MFs for every bit print file (22).
    - 146076: fix two zero-area triangles that Bambu dropped on import (open mesh), countersink 9.0 -> 9.5 mm for 4 mm screw heads up to 8.9 mm; fit re-checked.
    - 1051202: new bar magnet frame with 0.2 mm clearance built with build123d-mcp; right-angle and magnetic holders laid flat (no supports).
    - Two independent device-data readings (ISO 1173:2001, bit lengths, screw heads, magnets); screw, magnet and long-bit checks; all 158 screwdriver projects verified closed after Bambu import.
    Clau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
    [3x7_hex_bit_holder_angled_repaired_X2D_PETG.3mf, 8x4_hex_bit_holder_angled_repaired_X2D_PETG.3mf, Amana_Countersunk_Screw_Bit_Holder_X2D_PETG.3mf, Bit_holder_organizer_1770956_X2D_PETG.3mf, DIVIDER_1_X2D_PETG.3mf, DIVIDER_2_X2D_PETG.3mf, DIVIDER_3_X2D_PETG.3mf, DIVIDER_4_X2D_PETG.3mf]
2026-11-04 credits-3d: withdraw magnet parts, print Wera rails at 100% infill
    - Move every part that needs magnets to _wycofane_magnesy_2026-11-04/ (1051202 magnet frames, coin-magnet holders incl. Amana and DeWalt, magnetic bit holder, socket extension holder; Wera 10x3 magnet rail), nothing deleted.
    - Re-export the 12 remaining Wera rail projects with 100% infill (zig-zag) as the author recommends; slice results recorded.
    - Document that the Wera holder labels are already raised 1 mm and need no supports.
    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
    [Amana_Countersunk_Screw_Bit_Holder.3mf, Amana_Countersunk_Screw_Bit_Holder.stl, Amana_Countersunk_Screw_Bit_Holder_X2D_PETG.3mf, BAR_MAGNET_FRAME_60X10.stl, Bar_Magnet_Frame_60mmx10mm.3mf, Bore_Bit_Holder.3mf, DIVIDERS_AND_COIN_MAGNET_HOLDER.stl, Dewalt_90_degree_adapter_holder_v3.3mf]
2026-11-04 credits-3d: withdraw the whole 1051202 magnet system, split Wera offer, add notes
    - Move the remaining 1051202 files to _wycofane_magnesy_2026-11-04/ (whole system was designed for magnets); bits viewer rebuilt without it and with the current 146076 file.
    - Wera: variant table for all 140 holders (SKU, author test status, catalogue check, Bambu X2D grams/time/support count); flag 10 holders with extra plate support and 5 duplicate pairs.
    - DO_ZROBIENIA.txt: website variant selection plan, rail variants, follow-ups once a slicer session on the MiniPC is available.
    Claude-Session: https://claude.ai/code/session_01Vui5Q4gn4uG8dhYNZhYdgK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
    [3x7_hex_bit_holder_angled.stl, 3x7_hex_bit_holder_angled_repaired.3mf, 3x7_hex_bit_holder_angled_repaired_X2D_PETG.3mf, 8x4_hex_bit_holder_angled.3mf, 8x4_hex_bit_holder_angled.stl, 8x4_hex_bit_holder_angled_repaired.3mf, 8x4_hex_bit_holder_angled_repaired_X2D_PETG.3mf, DIVIDERS_1-8.stl]
2026-11-04 credits-3d: notes reflect the slimmed print package (what lives only in the repo)
    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
2026-11-04 credits-3d: notes describe the P-code folder layout of the print package
    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
2026-11-04 credits-3d: renumber register codes after moving 1051202 to the withdrawn tab
    Sheet: 1051202 (old P073) moved to the 'Wycofane' tab; P074-P079 became P073-P078 so the codes have no gap. Docs, notes, variant table (now P077 SKUs) and generator follow the new codes; raw result tags keep the old ones with a note.
    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
    [warianty_P077_uchwyty_wera.csv, warianty_P078_uchwyty_wera.csv]
